allenleejy/digicam/design/phone-v2/mockup.html

9:41

# sam's camera

24 photos2 videos80%

## New

6 not saved

## Saved

20

Select Save 6 new

LibraryThe camera's name in its own pixel font. New photos come first, so the main button always does the obvious thing. One floating bar, like Photos.

9:41

03/24 142 KB

Press and hold the photo to save it

Save

ViewerAlways dark, so the photo is the brightest thing on screen. Swipe sideways between photos, swipe down to close. The hint shows the first few times only.

9:41

Cancel

# 4 selected

All new

Save 4 to Photos

Select (dark mode)Drag across tiles to pick several at once. Picked tiles get an orange ring as well as the tick, so they're easy to spot at a glance.

9:41

# hi, sam

Your camera isn't connected. Two steps and your photos show up here.

1

Turn on Phone modeOn the camera, hold the middle button and pick the phone.

2

Join the camera's Wi-FiSettings, then Wi-Fi. It's saved, so no password this time.
digicam-sam

Looking for the camera

Not connectedWhat the home-screen app shows when opened away from the camera, if iOS keeps a copy of the page (to test). It keeps checking and opens the library by itself once the camera appears.

9:41

# sam's camera

24 photos2 videos

192.168.4.1

## Keep Digicam on your Home Screen

Opens full screen, like an app. Free, once.

- Tap Share in Safari's toolbar
- Choose Add to Home Screen
- Open Digicam from there next time

Not nowShow me

First visit, in SafariA one-time card asking to add the page to the Home Screen. It never shows inside the home-screen app itself.
