allenleejy/digicam/cad/renders/back.png

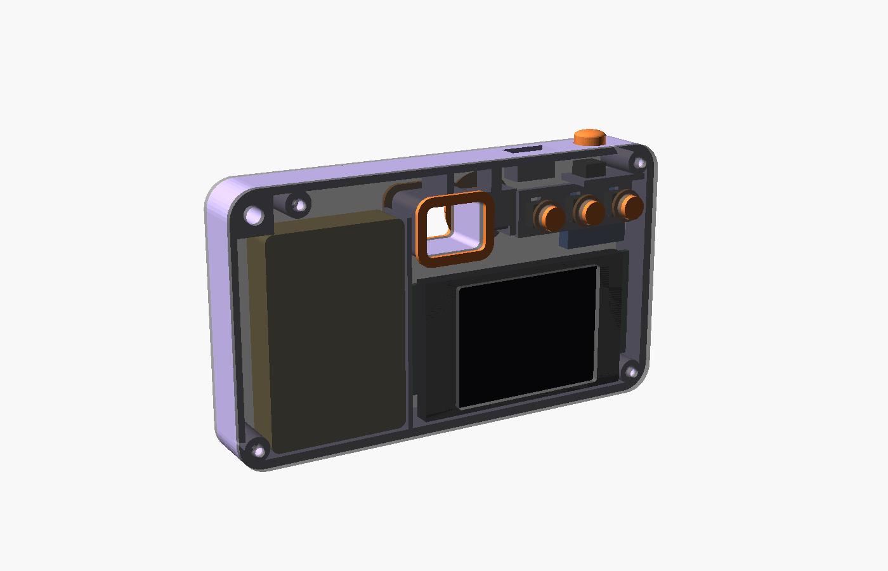
cad/renders/back.png
