allenleejy/digicam/cad/renders/exploded.png

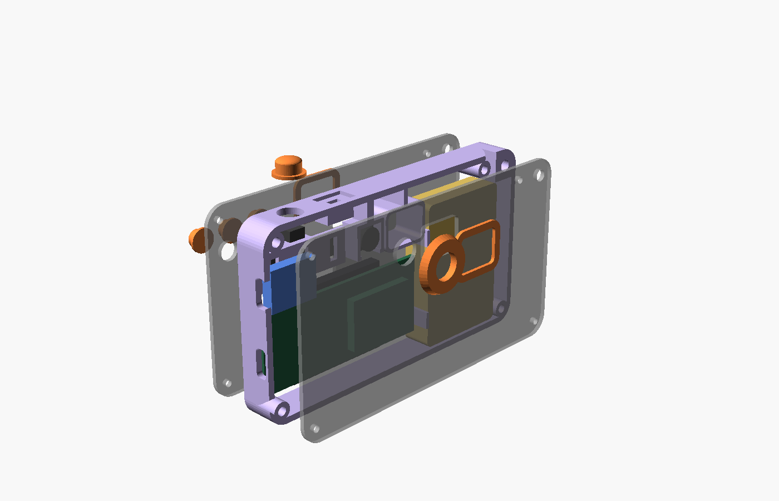
cad/renders/exploded.png
