allenleejy/digicam/cad/renders/front.png

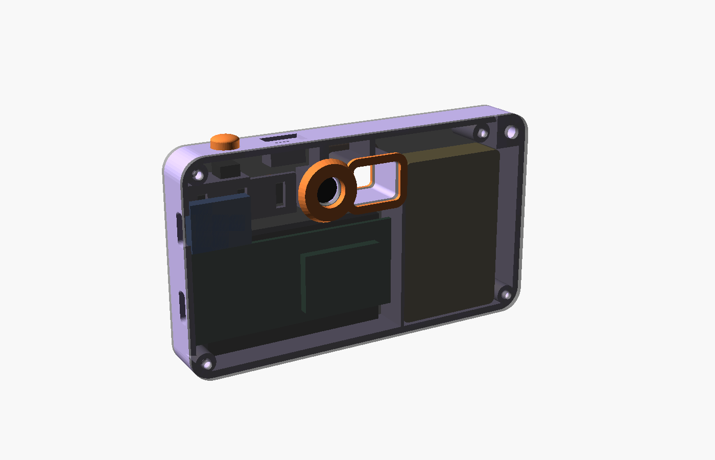
cad/renders/front.png
