allenleejy/digicam/cad/renders/fusion_back.png

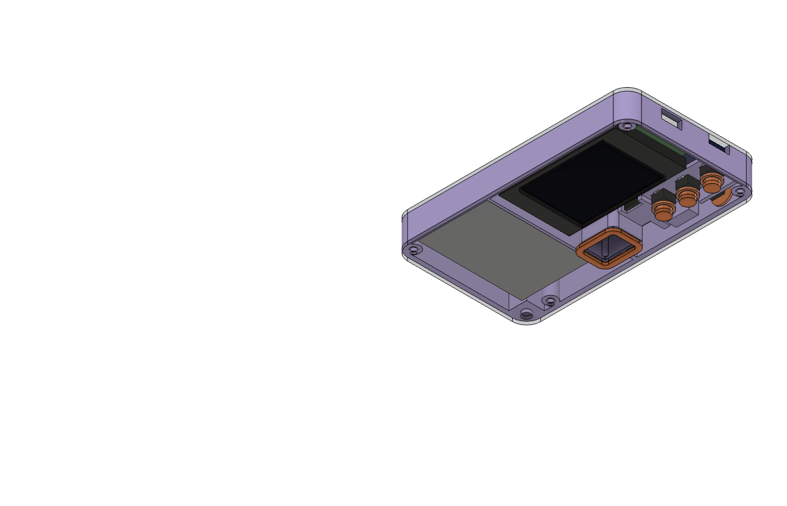
cad/renders/fusion_back.png
