allenleejy/digicam/cad/renders/fusion_front.png

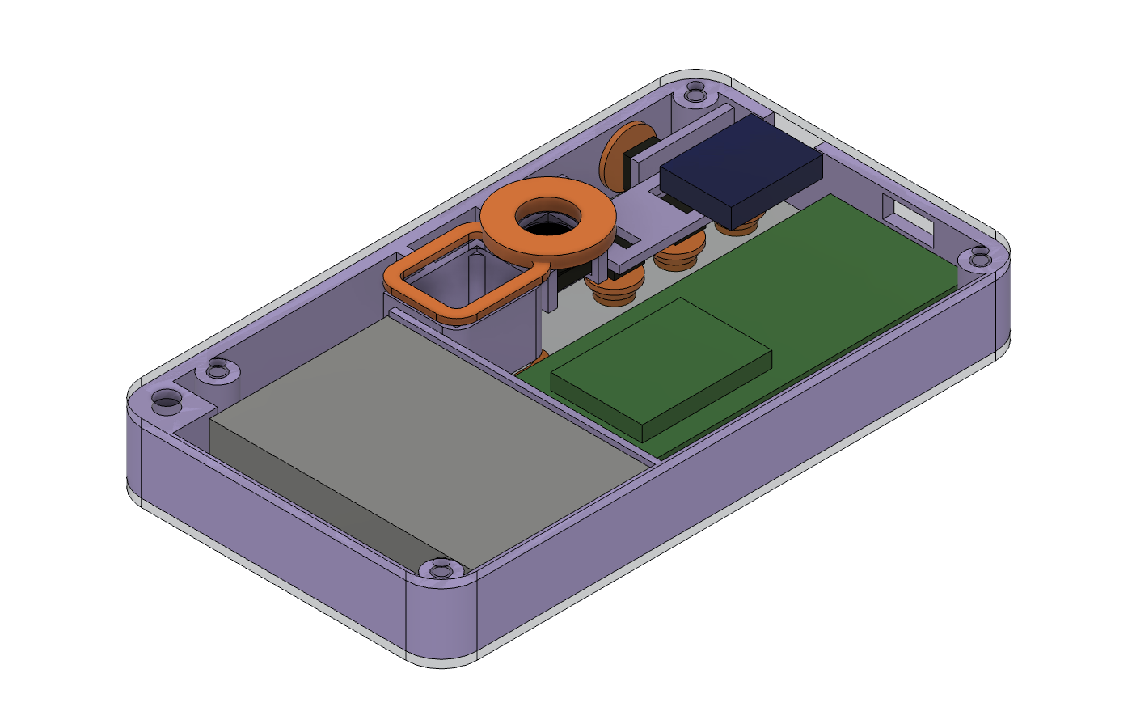
cad/renders/fusion_front.png
