allenleejy/digicam/cad/renders/screen-compare.png

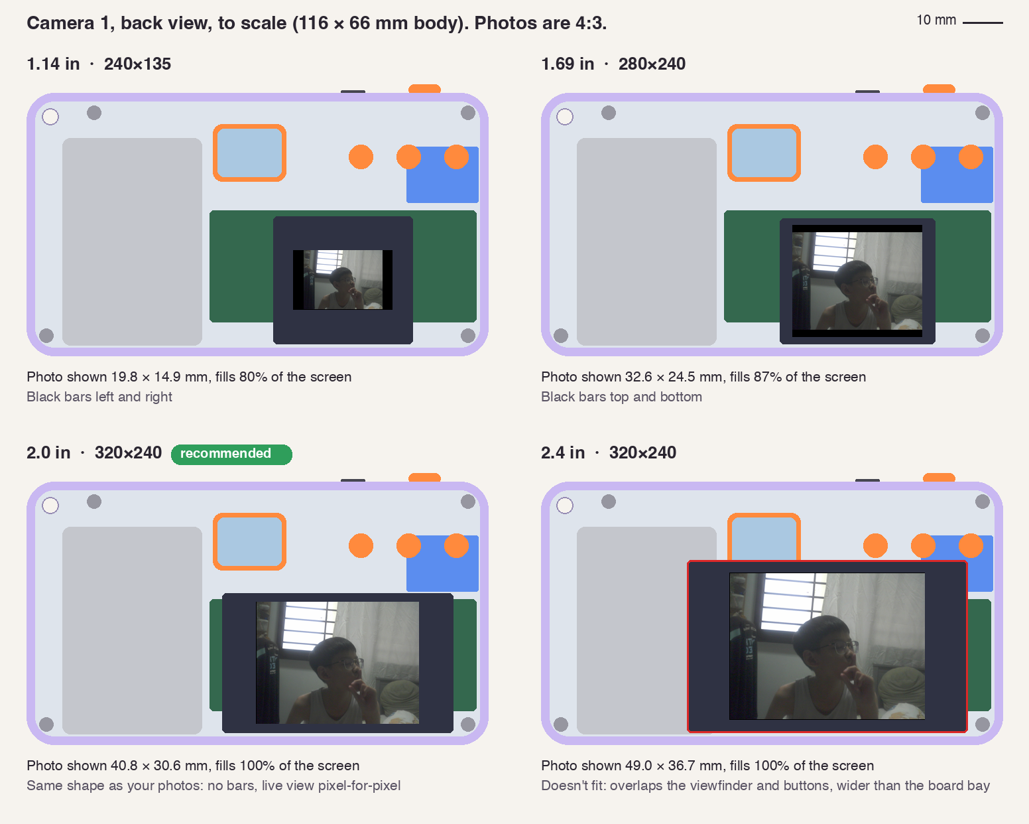
cad/renders/screen-compare.png
