allenleejy/digicam/cad/renders/simulator-2in.jpg

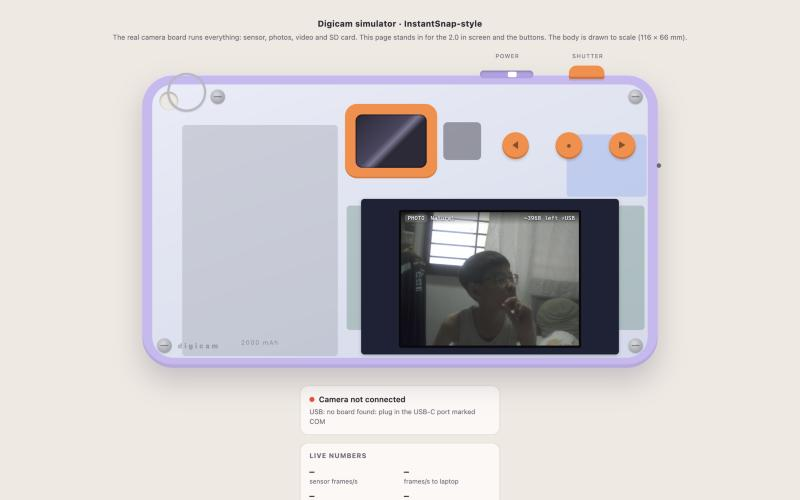
cad/renders/simulator-2in.jpg
