allenleejy/digicam/cad/renders/top.png

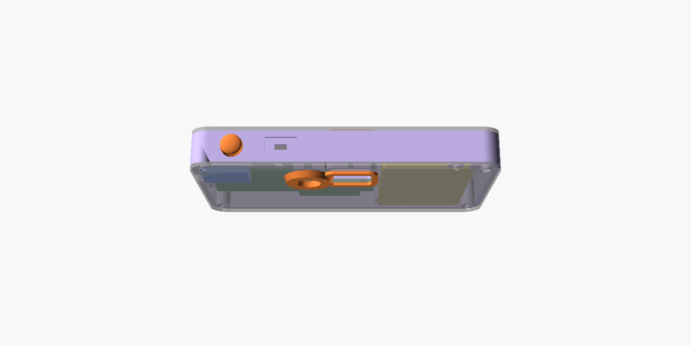
cad/renders/top.png
