allenleejy/digicam/cad/renders/v3/clear_exploded.png

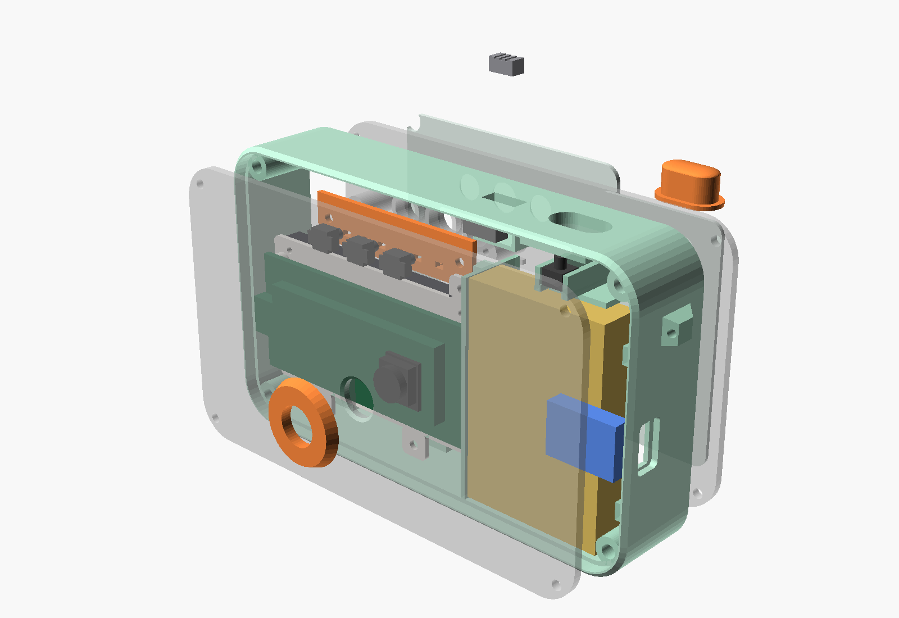
cad/renders/v3/clear_exploded.png
