allenleejy/digicam/cad/renders/v3/clear_front.png

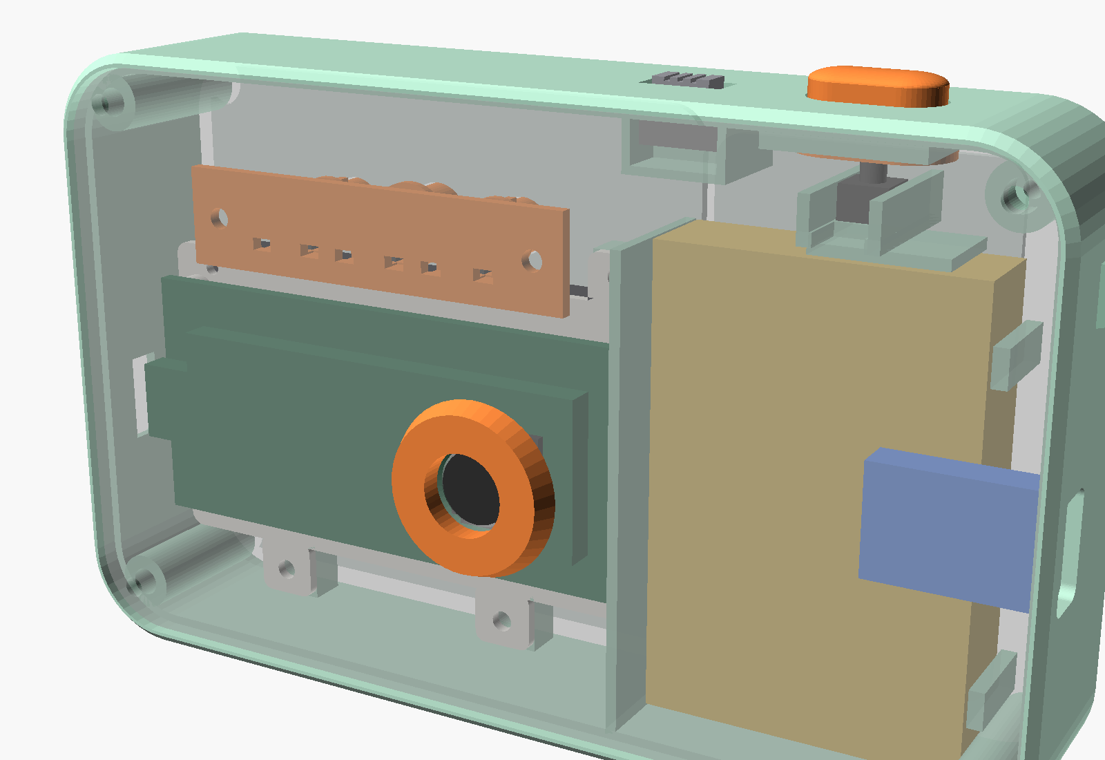
cad/renders/v3/clear_front.png
