allenleejy/digicam/cad/renders/v3/clear_inside.png

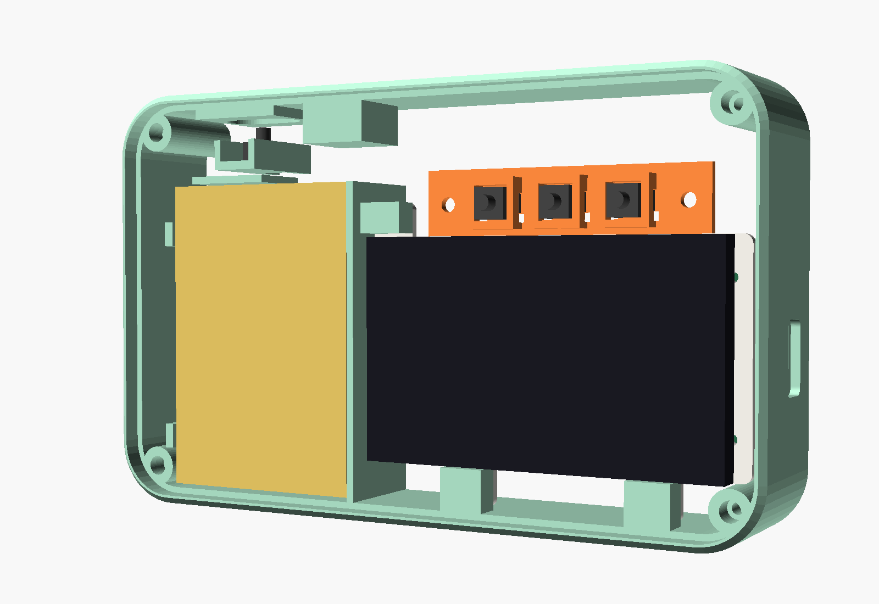
cad/renders/v3/clear_inside.png
