allenleejy/digicam/cad/renders/v3/retro_back.png

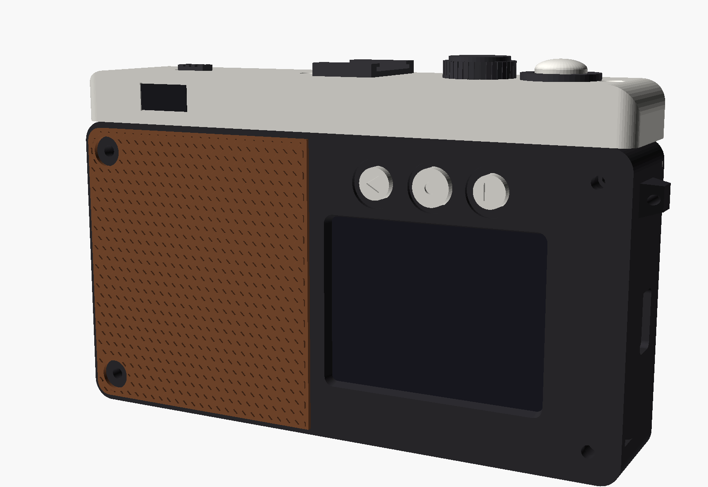
cad/renders/v3/retro_back.png
