allenleejy/digicam/cad/renders/v3/retro_exploded.png

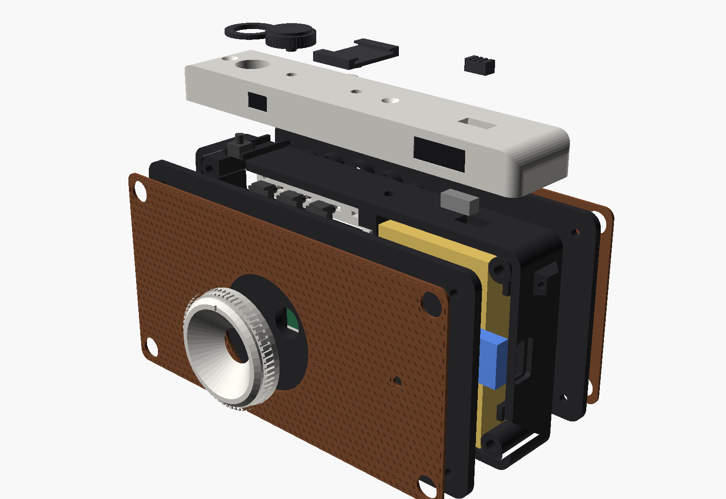
cad/renders/v3/retro_exploded.png
