allenleejy/digicam/cad/renders/v3/retro_inside.png

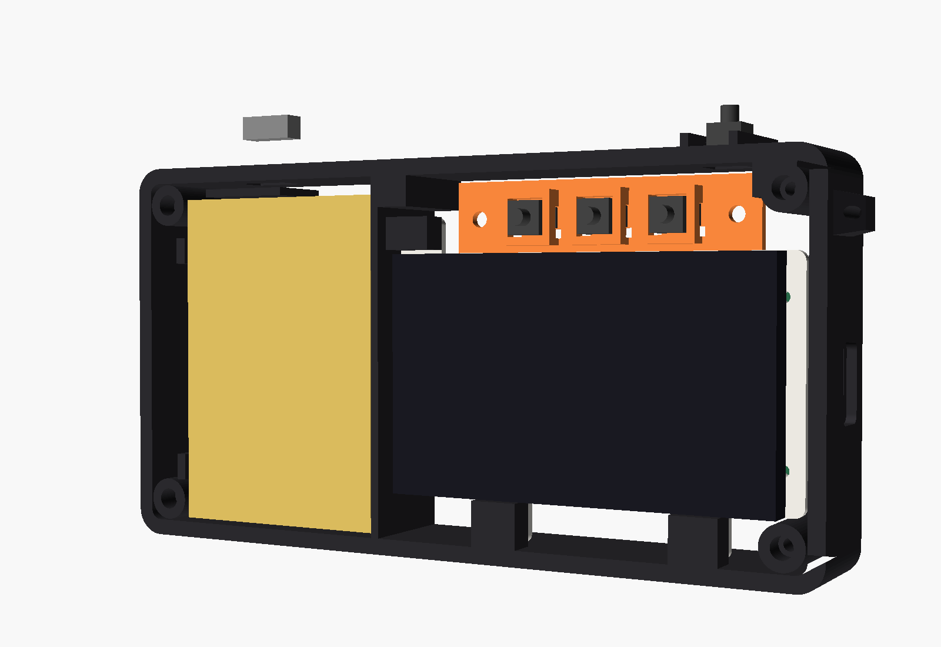
cad/renders/v3/retro_inside.png
