allenleejy/digicam/cad/renders/v3/sheet.png

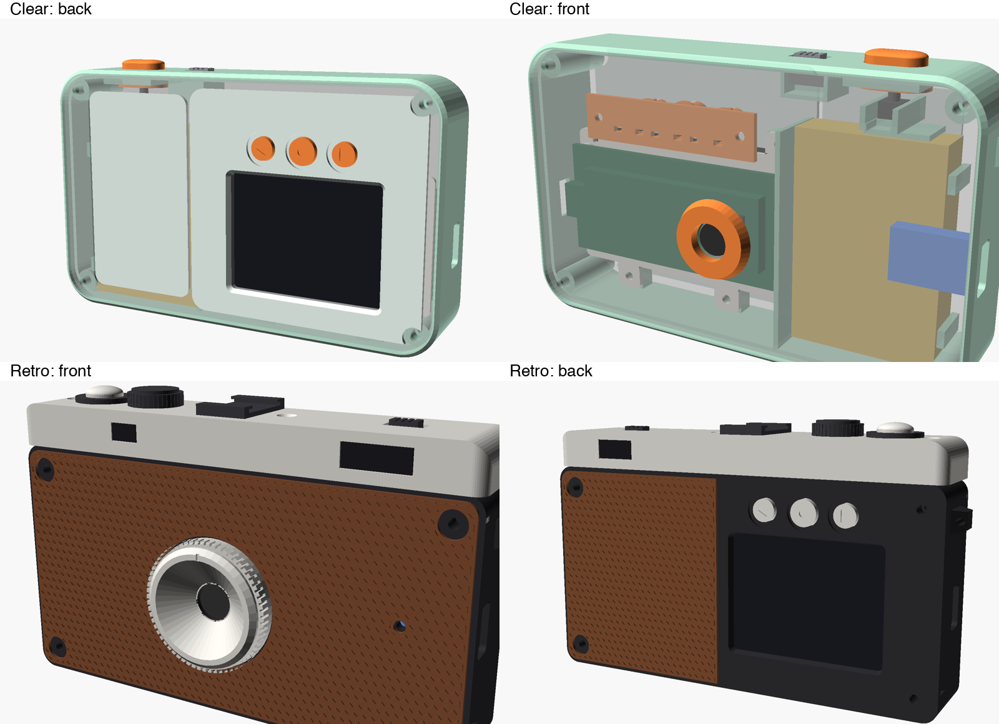
cad/renders/v3/sheet.png
