allenleejy/digicam/design/phone-v2/img/full.jpg

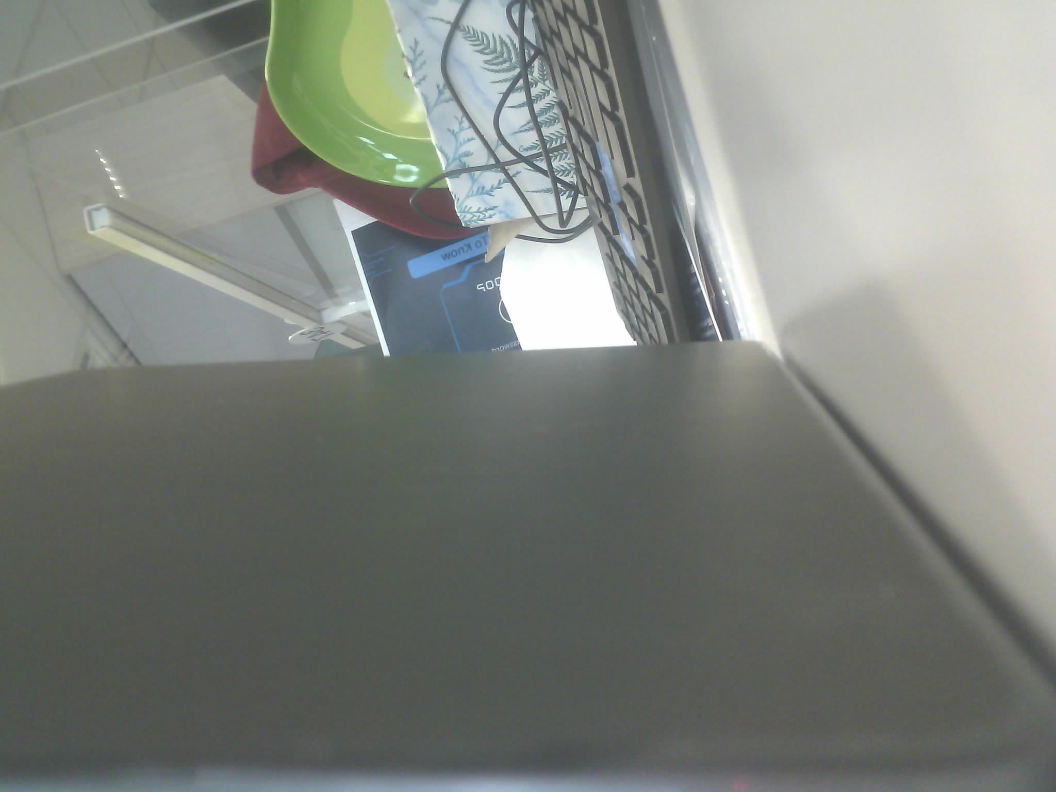
design/phone-v2/img/full.jpg
