allenleejy/digicam/design/phone-v2/img/t_DSC_0005.JPG

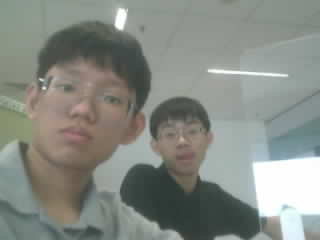
design/phone-v2/img/t_DSC_0005.JPG
