allenleejy/digicam/design/phone-v2/img/t_DSC_0006.JPG

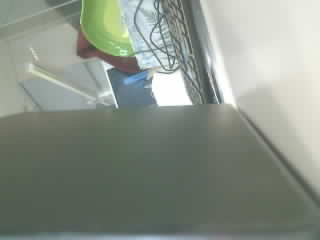
design/phone-v2/img/t_DSC_0006.JPG
