allenleejy/digicam/firmware/sim/out/01-boot.png

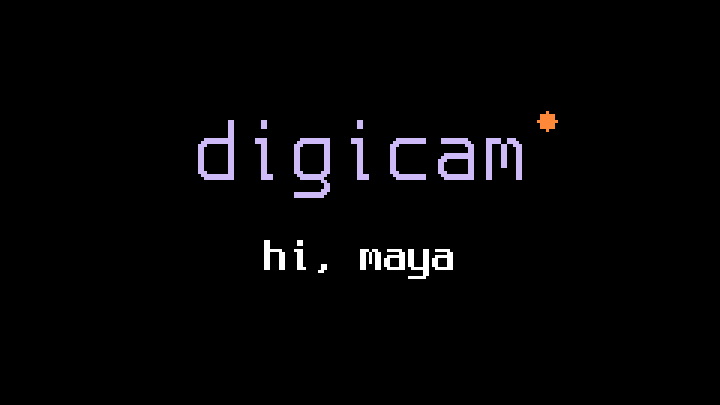
firmware/sim/out/01-boot.png
