allenleejy/digicam/firmware/sim/out/02-live-photo.png

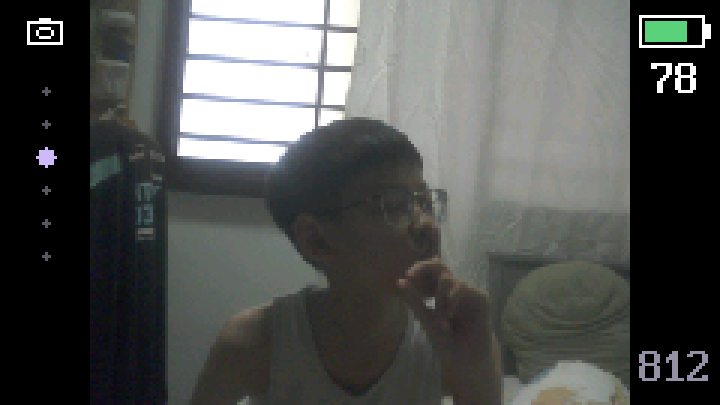
firmware/sim/out/02-live-photo.png
