allenleejy/digicam/firmware/sim/out/06-shutter-flash.png

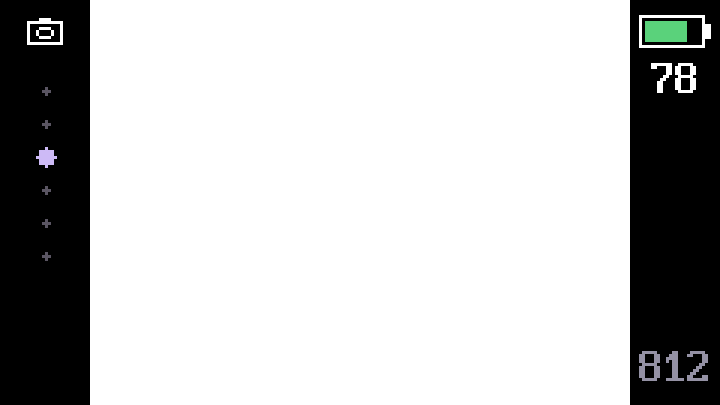
firmware/sim/out/06-shutter-flash.png
