allenleejy/digicam/firmware/sim/out/11-mode-dial.png

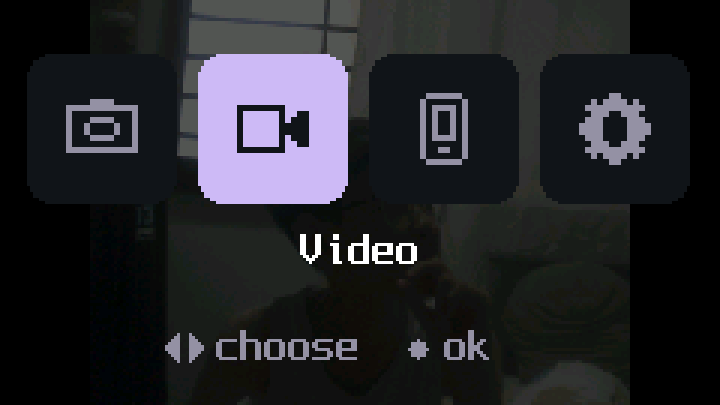
firmware/sim/out/11-mode-dial.png
