allenleejy/digicam/firmware/sim/out/14-delete.png

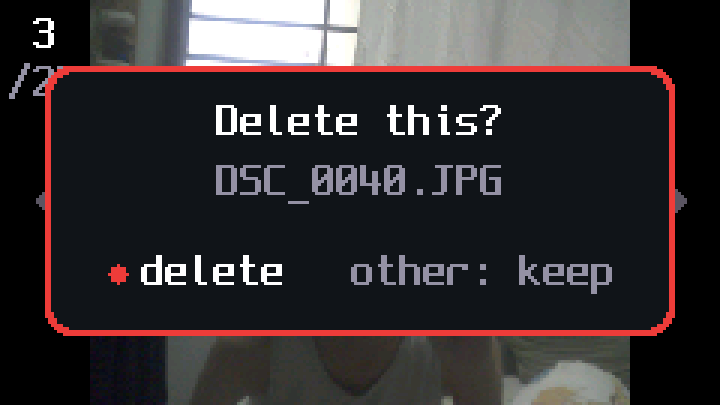
firmware/sim/out/14-delete.png
