allenleejy/digicam/firmware/sim/out/15-gallery-empty.png

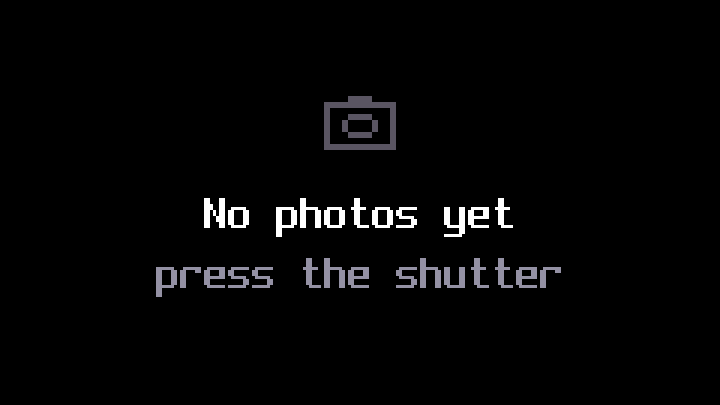
firmware/sim/out/15-gallery-empty.png
