allenleejy/digicam/firmware/sim/out/16-settings.png

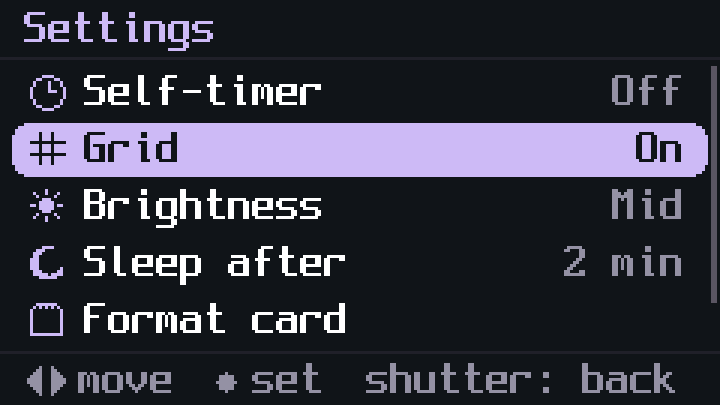
firmware/sim/out/16-settings.png
