allenleejy/digicam/firmware/sim/out/17-format.png

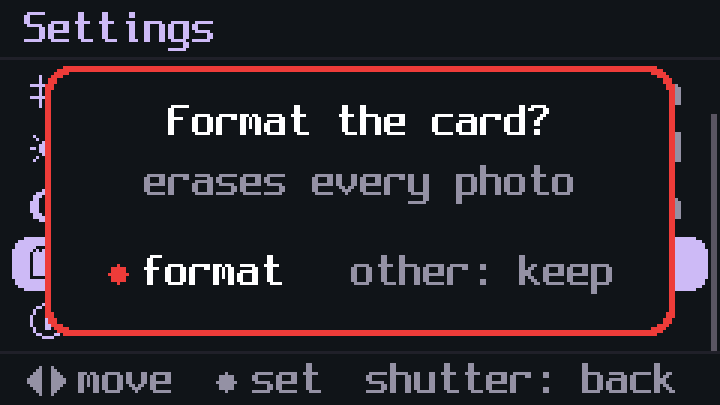
firmware/sim/out/17-format.png
