allenleejy/digicam/firmware/sim/out/18-about.png

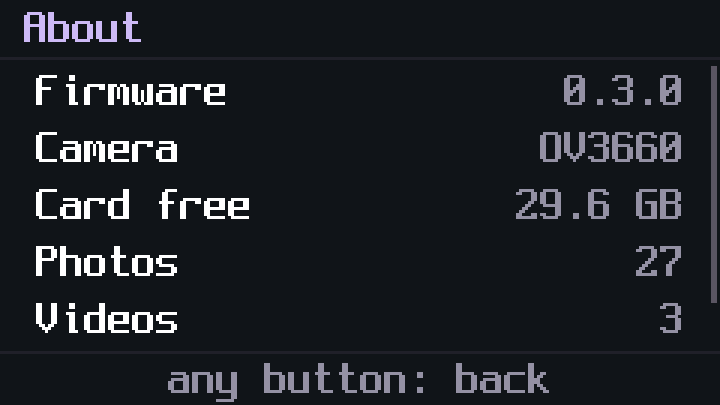
firmware/sim/out/18-about.png
