allenleejy/digicam/firmware/sim/out/19-no-camera.png

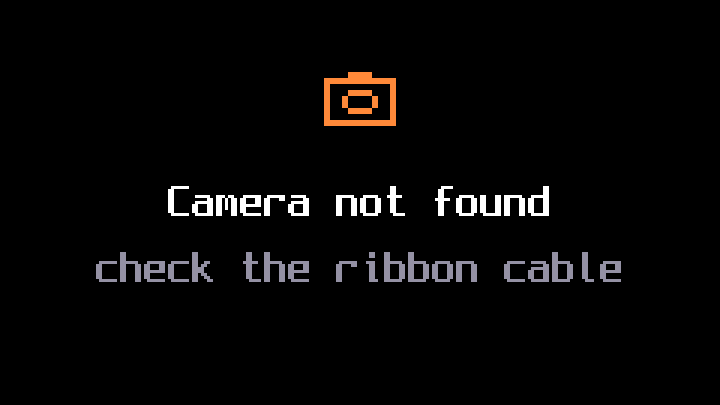
firmware/sim/out/19-no-camera.png
