allenleejy/digicam/firmware/sim/out/21-mode-phone.png

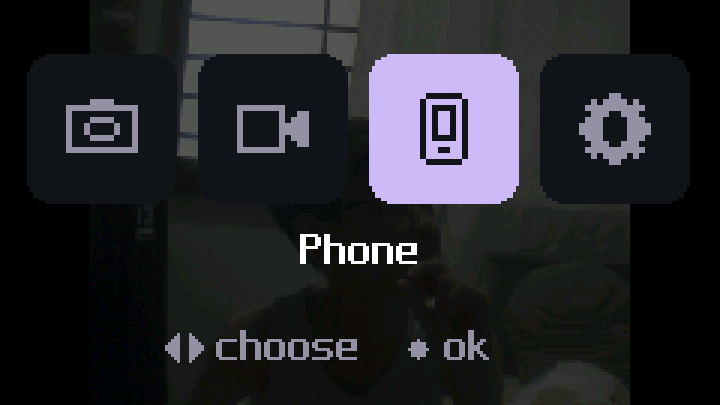
firmware/sim/out/21-mode-phone.png
