allenleejy/digicam/firmware/sim/out/22-phone-join.png

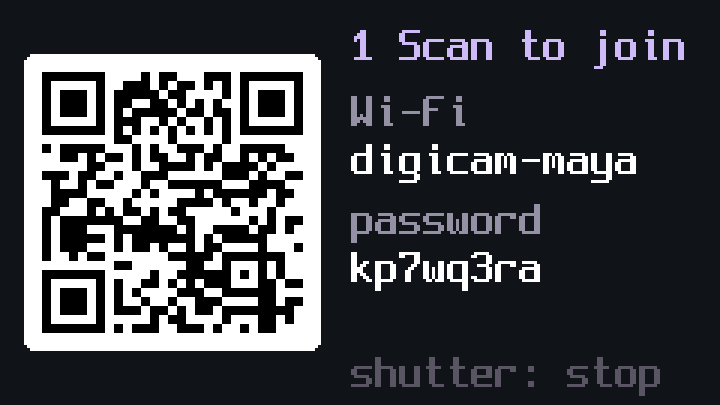
firmware/sim/out/22-phone-join.png
