allenleejy/digicam/firmware/sim/out/23-phone-open.png

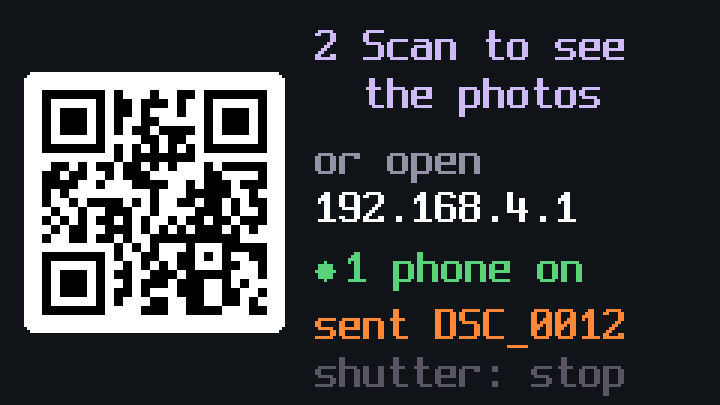
firmware/sim/out/23-phone-open.png
