allenleejy/digicam/firmware/sim/out/phone-screens.png

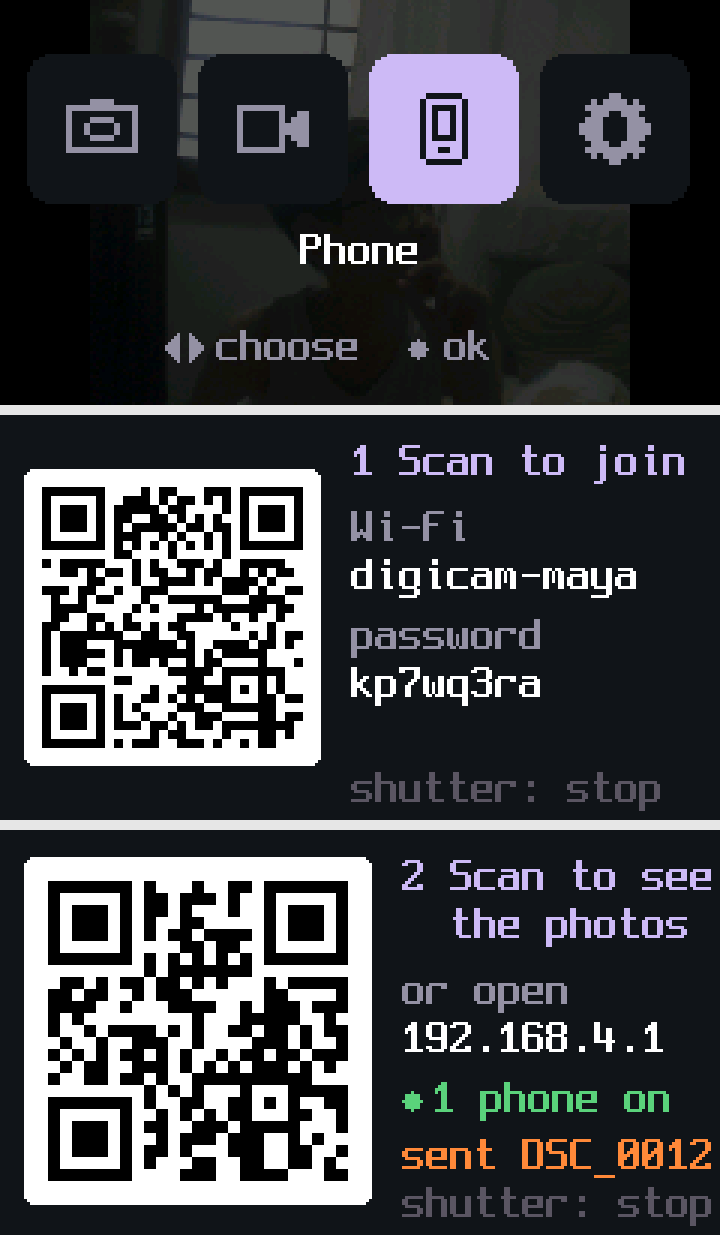
firmware/sim/out/phone-screens.png
