allenleejy/digicam/firmware/sim/out/sheet.png

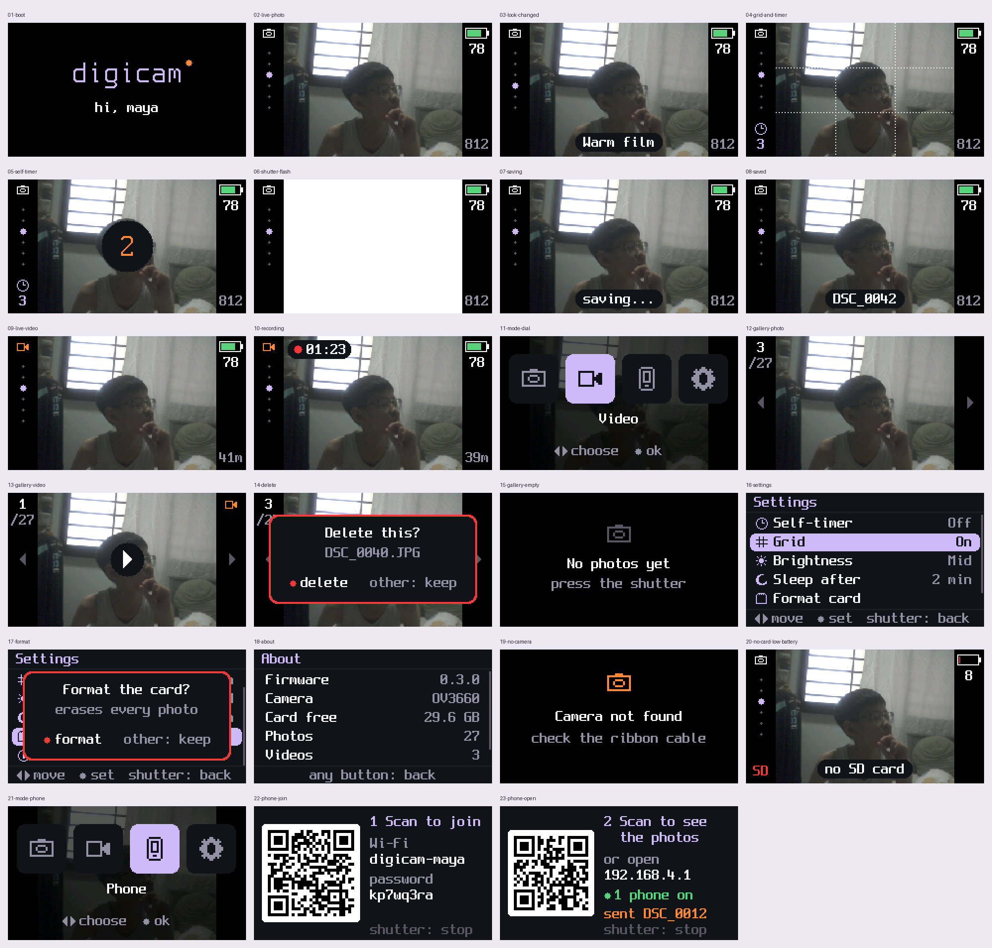
firmware/sim/out/sheet.png
