allenleejy/digicam/host/shots/a-mode.png

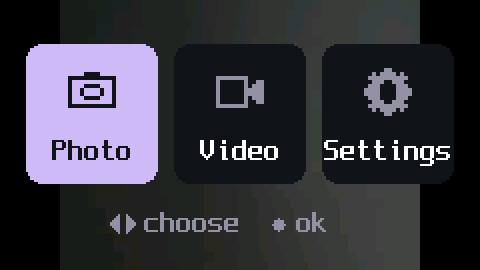
host/shots/a-mode.png
