allenleejy/digicam/host/shots/b-mode-settings.png

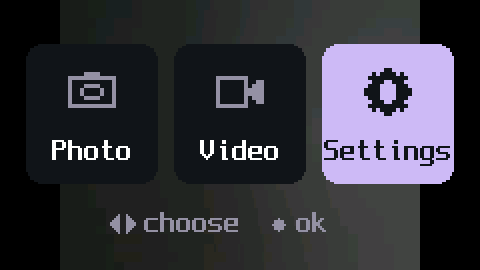
host/shots/b-mode-settings.png
