allenleejy/digicam/host/shots/c-settings.png

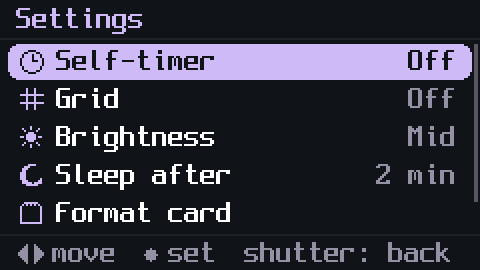
host/shots/c-settings.png
