allenleejy/digicam/host/shots/f-live-grid.png

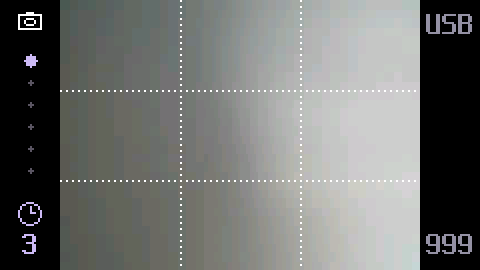
host/shots/f-live-grid.png
