allenleejy/digicam/host/shots/g-countdown.png

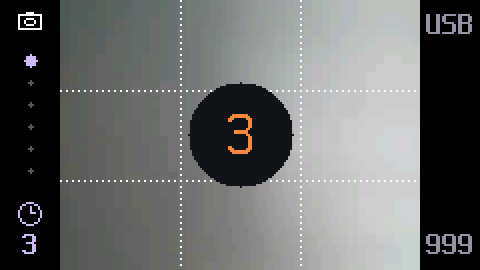
host/shots/g-countdown.png
