allenleejy/digicam/host/shots/p1-dial.png

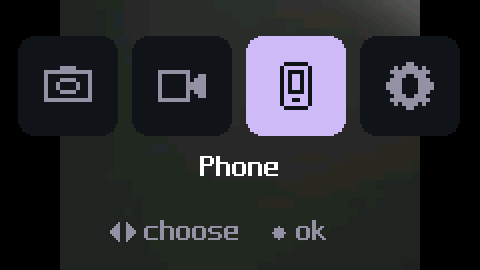
host/shots/p1-dial.png
