allenleejy/digicam/host/shots/p2-phone.png

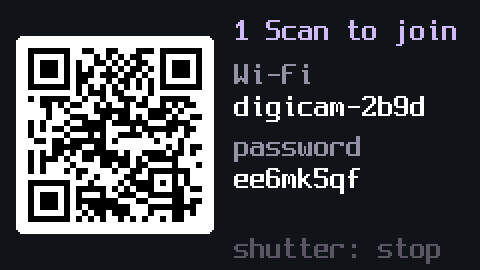
host/shots/p2-phone.png
