allenleejy/digicam/host/shots/walk.png

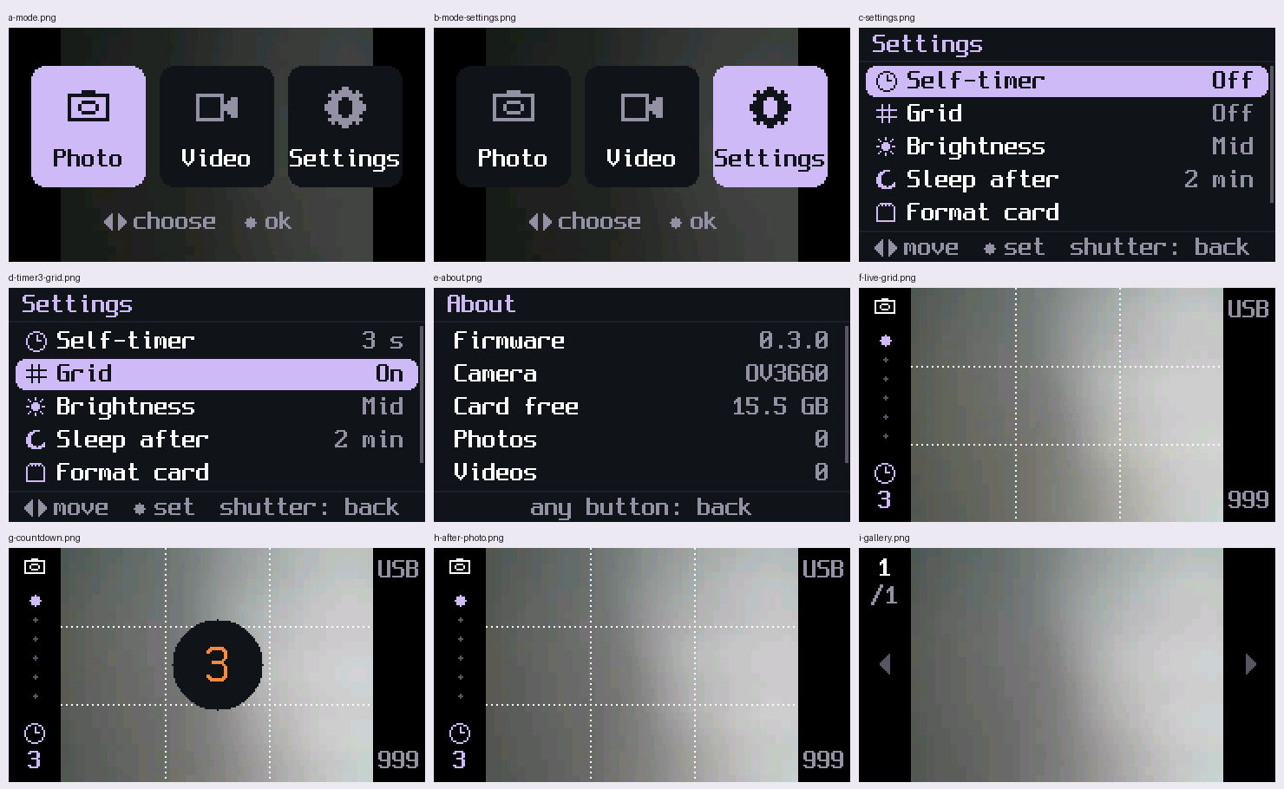
host/shots/walk.png
