allenleejy/digicam/cad/export/camera1_assembly.step

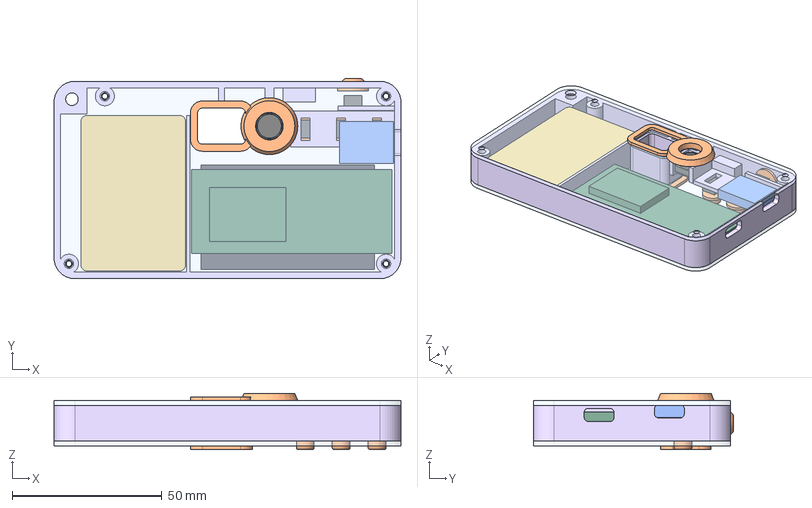
[picture p48: CAD file, 2026-10-21]
cad/export/camera1_assembly.step
116.0 x 67.0 x 18.8 mm
Frame
Back plate (clear)
Front plate (clear)
Lens ring
Viewfinder trim front
Viewfinder trim back
Shutter cap
Button cap prev
Button cap ok
Button cap next
REF battery 103450 2000mAh
REF GOOUUU ESP32-S3-CAM board
REF screen 2.0 in module
REF charge-boost module
REF OV3660 camera module
REF back buttons x3
REF shutter switch
REF slide switch
