allenleejy/digicam/cad/export/step_parts/button_cap_ok.step

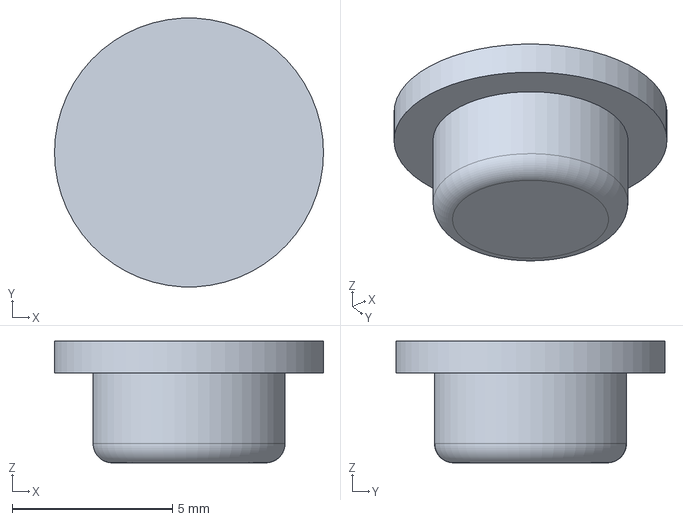
[picture p49: CAD file, 2026-10-21]
cad/export/step_parts/button_cap_ok.step
8.40 x 8.39 x 3.80 mm
