allenleejy/digicam/cad/export/v3/clear/back_plate.stl

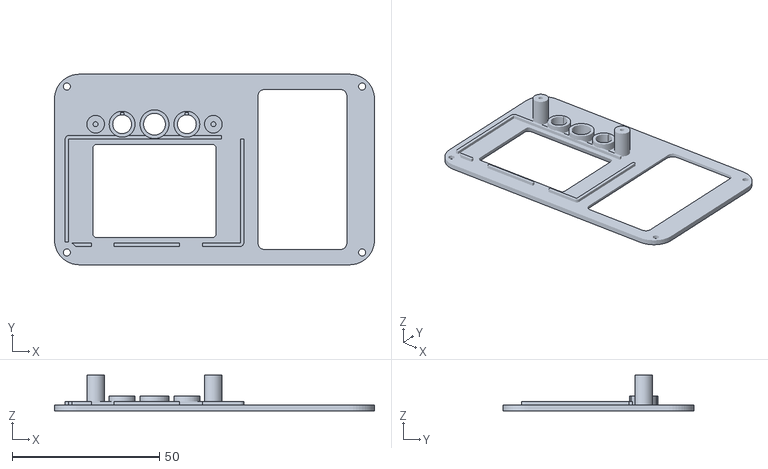
[picture p50: CAD file, 2026-10-23]
cad/export/v3/clear/back_plate.stl
108.8 x 64.8 x 12.1
