allenleejy/digicam/cad/export/v3/retro/window_inserts.stl

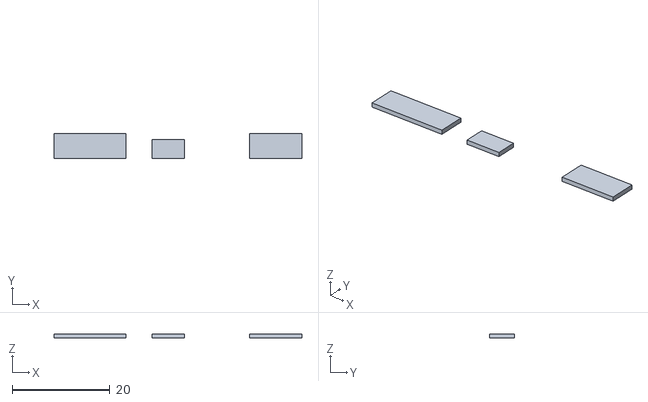
[picture p51: CAD file, 2026-10-23]
cad/export/v3/retro/window_inserts.stl
50.7 x 5.10 x 0.8
