allenleejy/digicam/guide/models/w_screen_4.stl

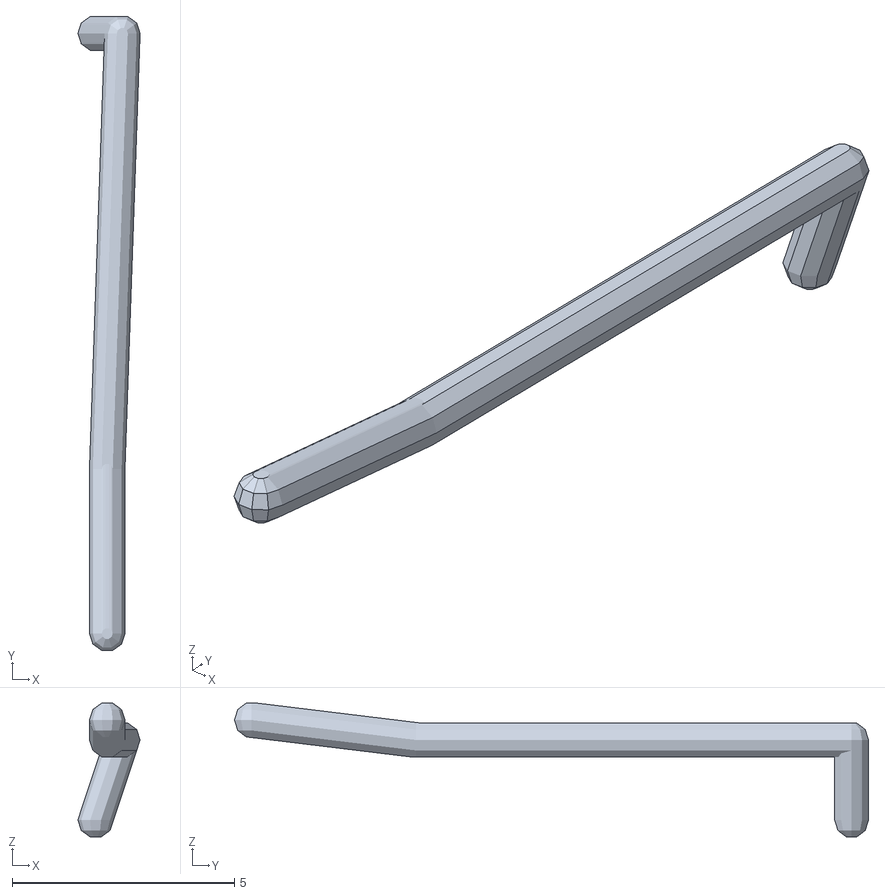
[picture p52: CAD file, 2026-10-21]
guide/models/w_screen_4.stl
1.40 x 14.3 x 3.01
