allenleejy/digicam/cad/export/step_parts/front_plate.step

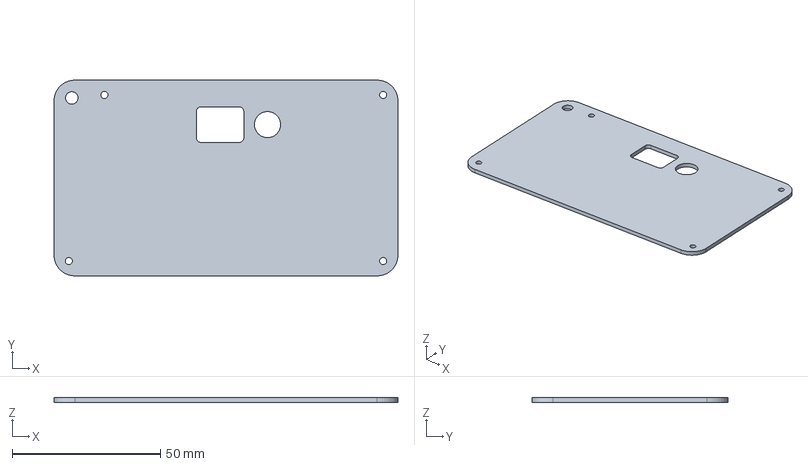
[picture p53: CAD file, 2026-10-21]
cad/export/step_parts/front_plate.step
116.0 x 66.0 x 1.60 mm
