allenleejy/digicam/cad/export/v3/clear/carrier.stl

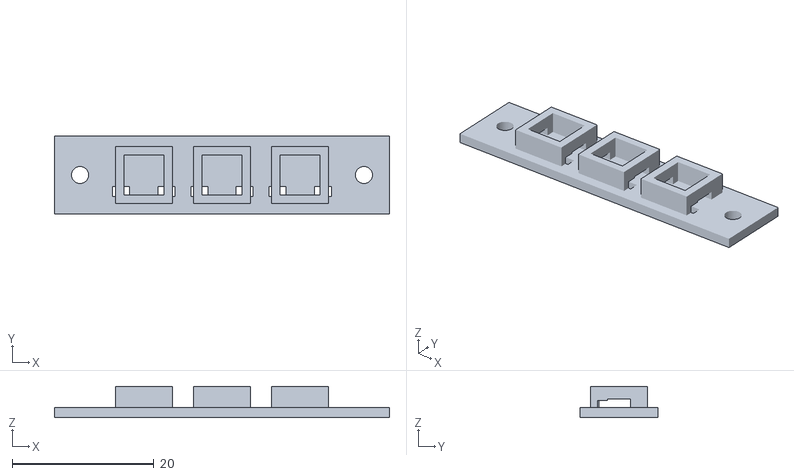
[picture p54: CAD file, 2026-10-23]
cad/export/v3/clear/carrier.stl
47.2 x 11.0 x 4.40
