allenleejy/digicam/cad/export/v3/retro/sled.stl

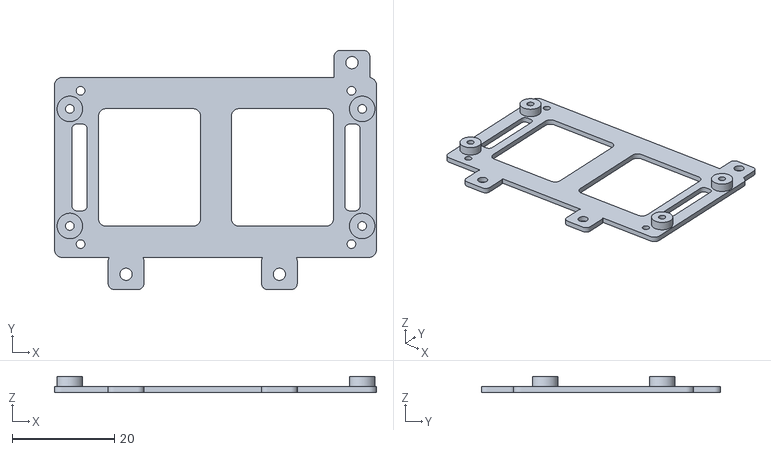
[picture p55: CAD file, 2026-10-23]
cad/export/v3/retro/sled.stl
63.0 x 46.8 x 3.20
