allenleejy/digicam/guide/models/frame.stl

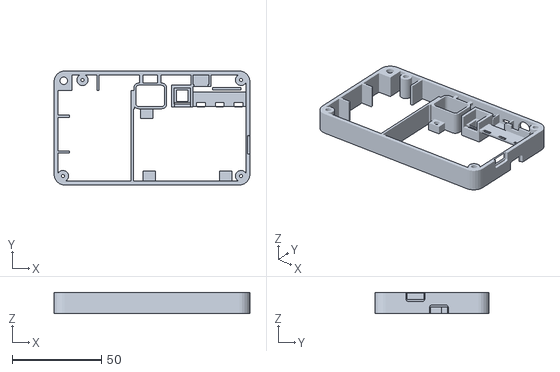
[picture p56: CAD file, 2026-10-21]
guide/models/frame.stl
110.0 x 64.0 x 11.9
