allenleejy/digicam/cad/export/step_parts/shutter_cap.step

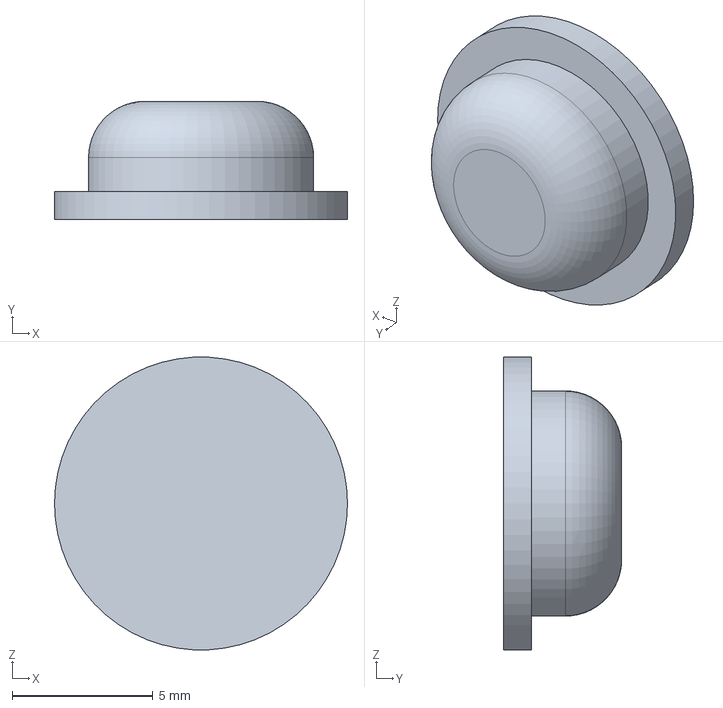
[picture p57: CAD file, 2026-10-21]
cad/export/step_parts/shutter_cap.step
10.4 x 4.20 x 10.4 mm
