allenleejy/digicam/cad/export/v3/clear/front_plate.stl

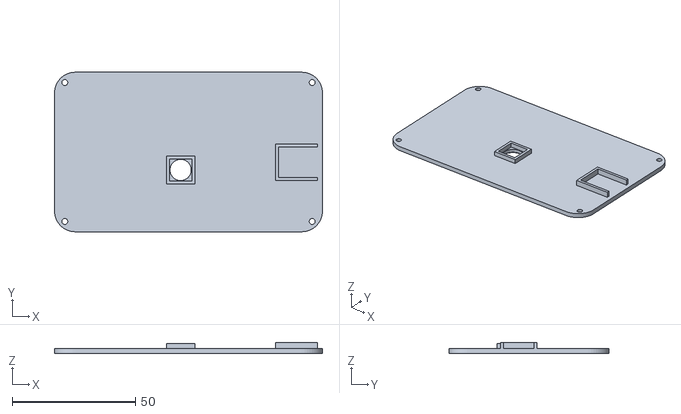
[picture p58: CAD file, 2026-10-23]
cad/export/v3/clear/front_plate.stl
108.8 x 64.8 x 4.50
