allenleejy/digicam/cad/export/v3/retro/lens_barrel.stl

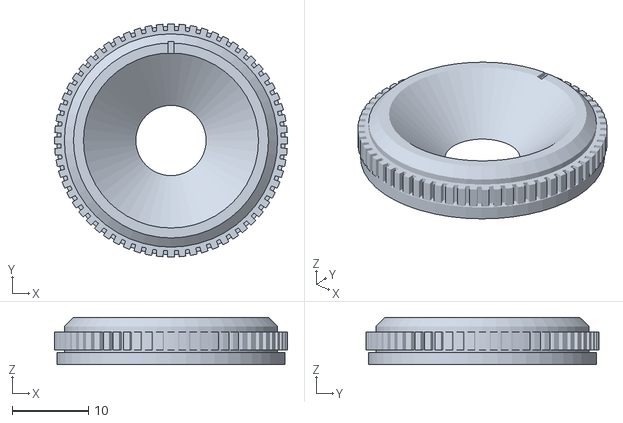
[picture p59: CAD file, 2026-10-23]
cad/export/v3/retro/lens_barrel.stl
30.6 x 30.6 x 6.20
