allenleejy/digicam/guide/models/w_gnd.stl

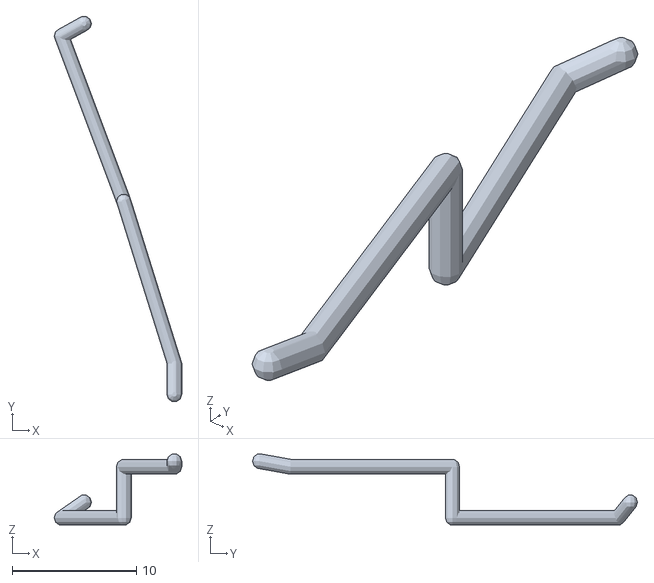
[picture p60: CAD file, 2026-10-21]
guide/models/w_gnd.stl
10.3 x 30.9 x 5.69
