allenleejy/digicam/cad/export/step_parts/lens_ring.step

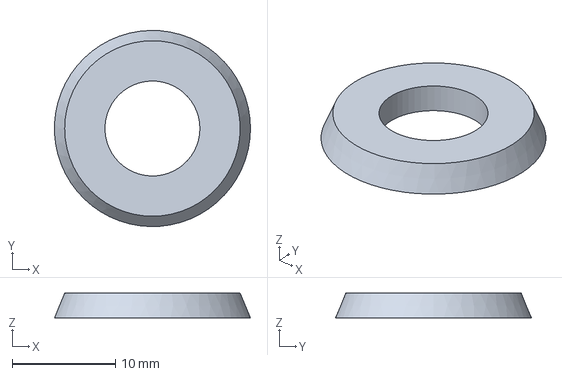
[picture p61: CAD file, 2026-10-21]
cad/export/step_parts/lens_ring.step
19.0 x 19.0 x 2.40 mm
