allenleejy/digicam/cad/export/v3/retro/frame.stl

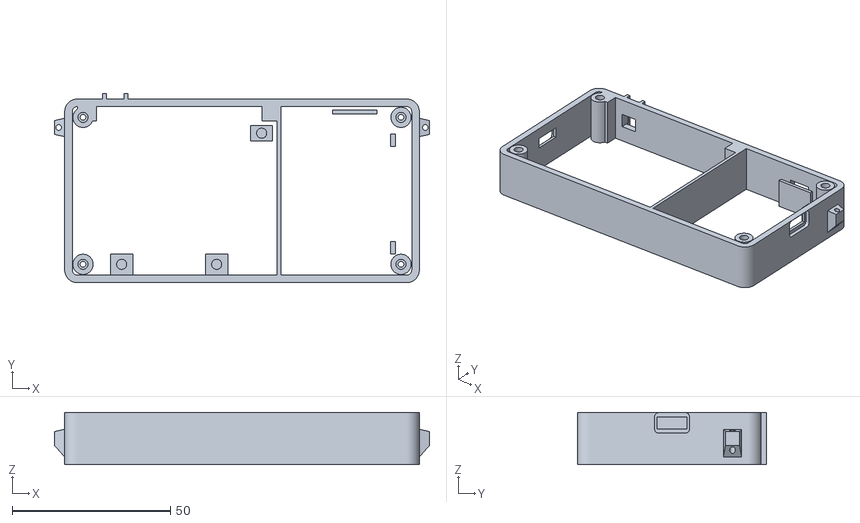
[picture p62: CAD file, 2026-10-23]
cad/export/v3/retro/frame.stl
118.4 x 59.8 x 16.5
