allenleejy/digicam/cad/export/vf_frames.stl

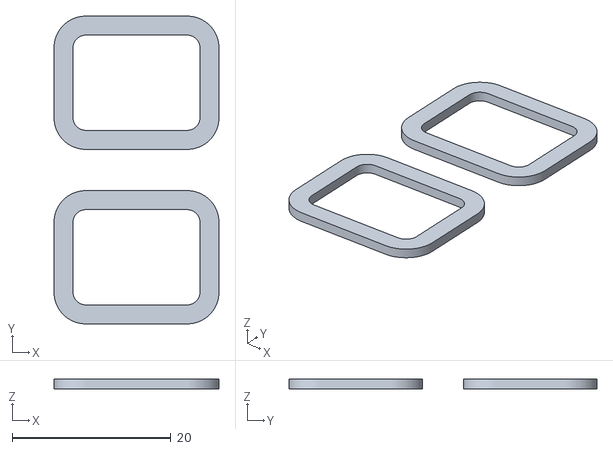
[picture p63: CAD file, 2026-10-21]
cad/export/vf_frames.stl
20.8 x 38.8 x 1.20
