allenleejy/digicam/cad/export/step_parts/frame.step

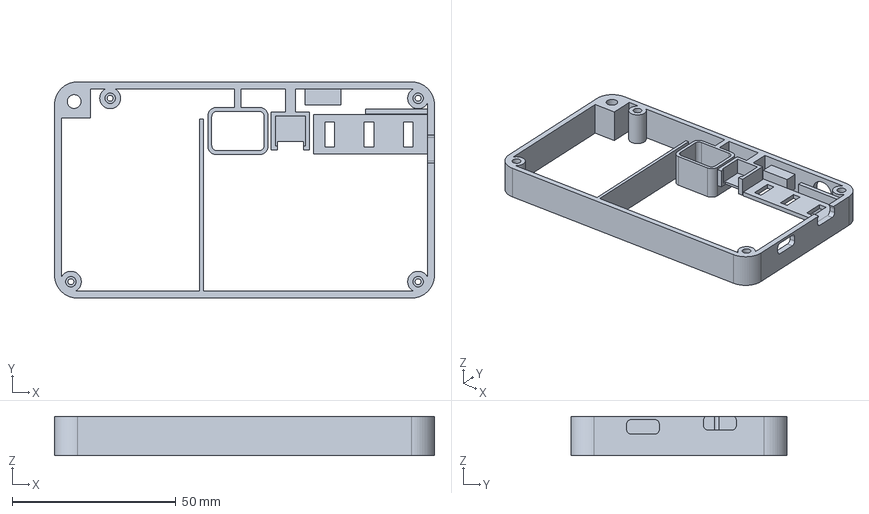
[picture p64: CAD file, 2026-10-21]
cad/export/step_parts/frame.step
116.0 x 66.0 x 12.0 mm
