allenleejy/digicam/cad/export/v3/retro/top_plate.stl

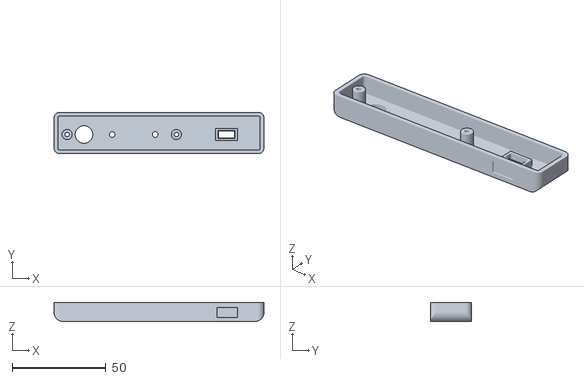
[picture p65: CAD file, 2026-10-23]
cad/export/v3/retro/top_plate.stl
112.0 x 22.1 x 10.2
