allenleejy/digicam/guide/models/vf_front.stl

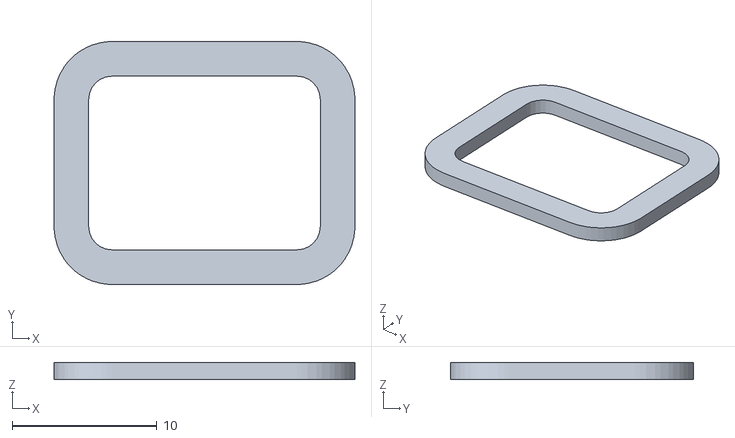
[picture p66: CAD file, 2026-10-21]
guide/models/vf_front.stl
20.8 x 16.8 x 1.20
