allenleejy/digicam/cad/export/v3/clear/bezel.stl

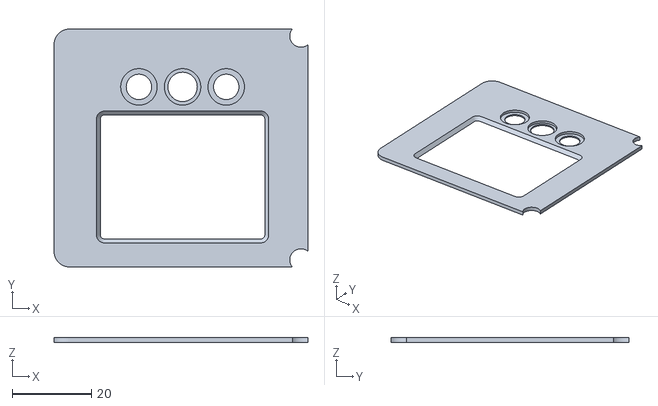
[picture p67: CAD file, 2026-10-23]
cad/export/v3/clear/bezel.stl
64.0 x 60.0 x 1.20
