allenleejy/digicam/cad/export/v3/retro/leatherette.stl

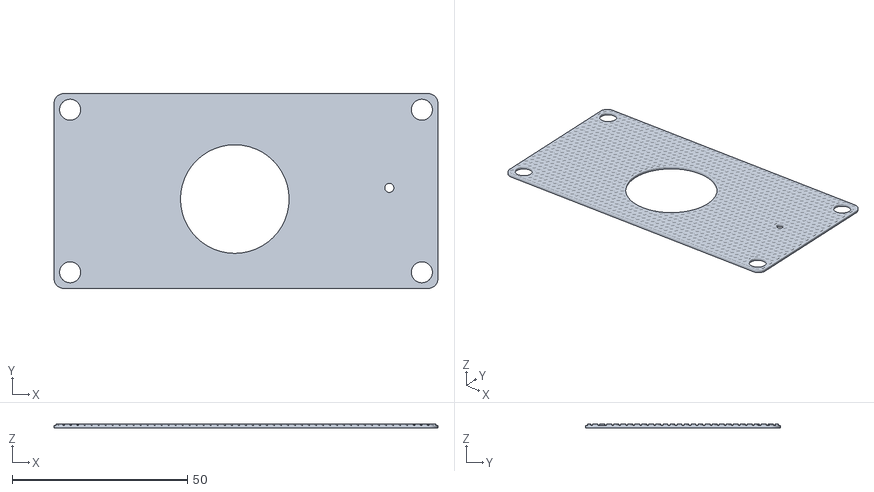
[picture p68: CAD file, 2026-10-23]
cad/export/v3/retro/leatherette.stl
109.6 x 55.6 x 1.19
