allenleejy/digicam/guide/models/board_pads.stl

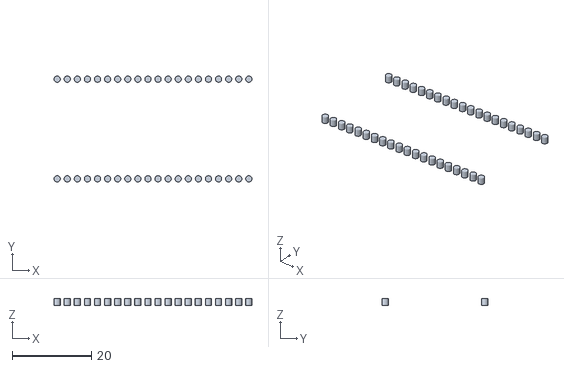
[picture p69: CAD file, 2026-10-21]
guide/models/board_pads.stl
49.9 x 26.7 x 1.70
