allenleejy/digicam/cad/export/v3/clear/frame.stl

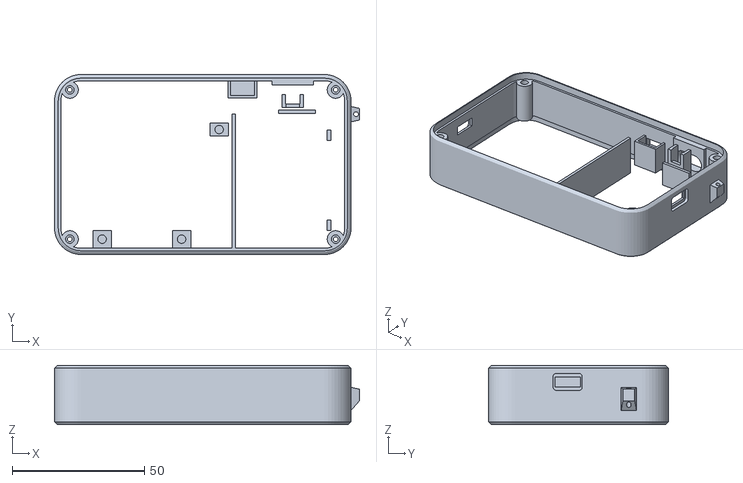
[picture p70: CAD file, 2026-10-23]
cad/export/v3/clear/frame.stl
115.2 x 68.0 x 22.3
