allenleejy/digicam/cad/export/v3/retro/front_plate.stl

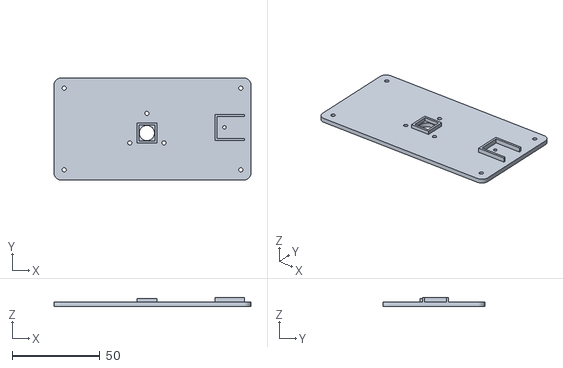
[picture p71: CAD file, 2026-10-23]
cad/export/v3/retro/front_plate.stl
112.0 x 58.0 x 4.90
