allenleejy/digicam/guide/models/w_screen_2.stl

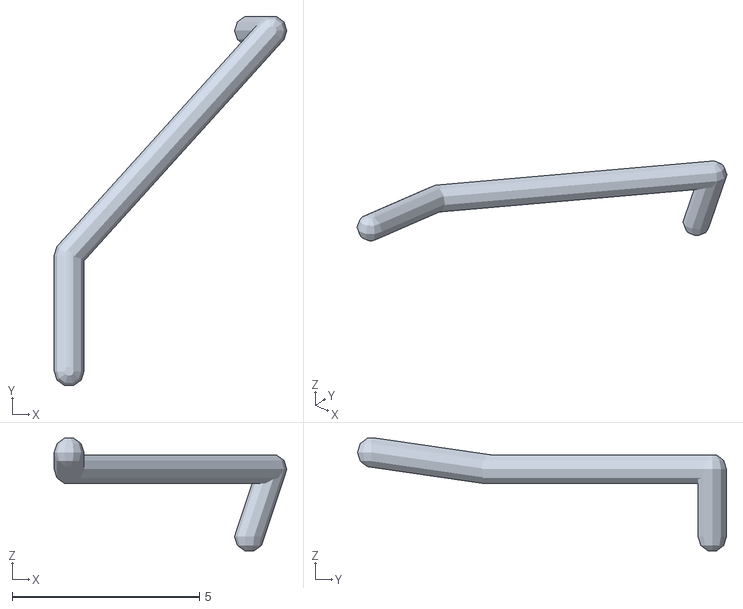
[picture p72: CAD file, 2026-10-21]
guide/models/w_screen_2.stl
6.22 x 9.86 x 3.01
