allenleejy/digicam/cad/export/v3/clear/caps.stl

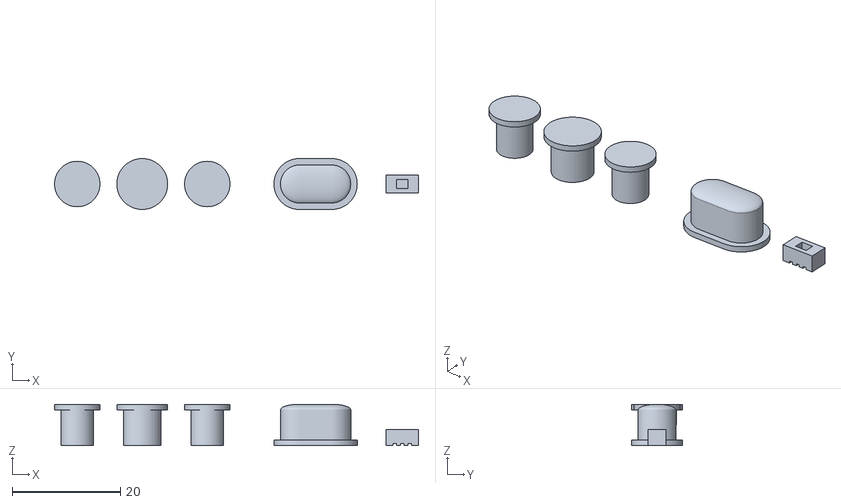
[picture p74: CAD file, 2026-10-23]
cad/export/v3/clear/caps.stl
67.2 x 9.40 x 7.65
