allenleejy/digicam/cad/export/v3/retro/back_plate.stl

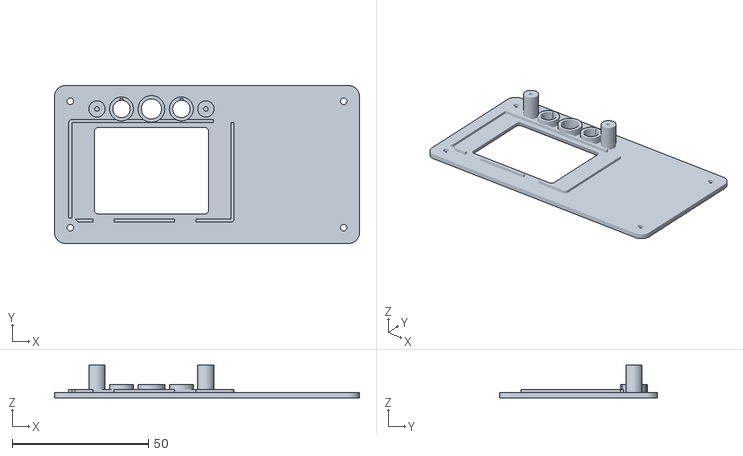
[picture p75: CAD file, 2026-10-23]
cad/export/v3/retro/back_plate.stl
112.0 x 58.0 x 12.1
