allenleejy/digicam/guide/models/w_buttons.stl

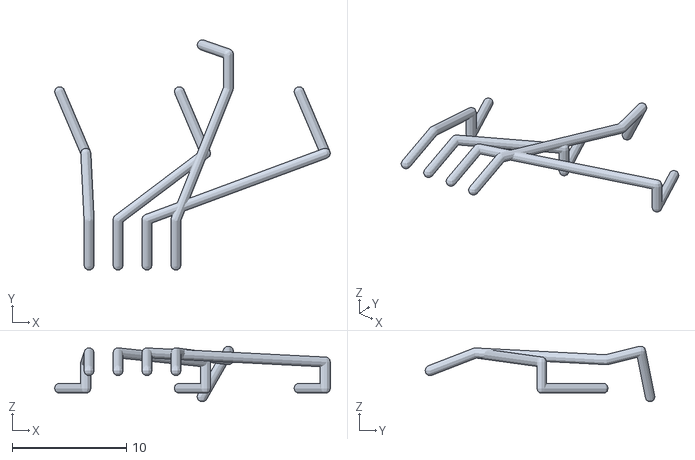
[picture p76: CAD file, 2026-10-21]
guide/models/w_buttons.stl
24.2 x 20.2 x 4.86
