allenleejy/digicam/cad/export/v3/clear/panel.stl

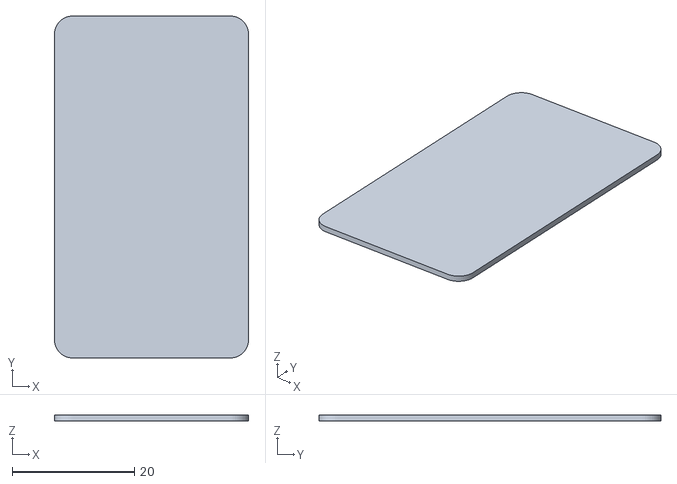
[picture p77: CAD file, 2026-10-23]
cad/export/v3/clear/panel.stl
31.8 x 56.0 x 1.00
