allenleejy/digicam/cad/export/v3/retro/caps.stl

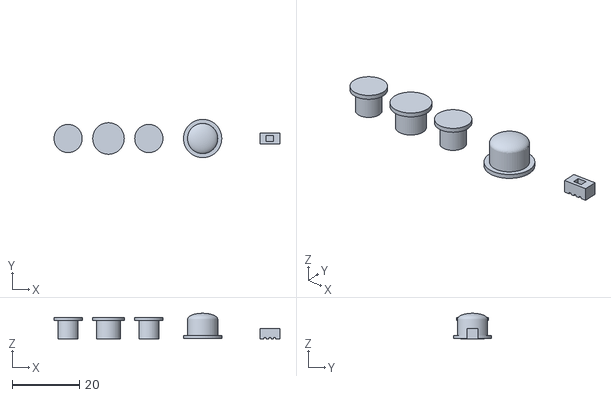
[picture p78: CAD file, 2026-10-23]
cad/export/v3/retro/caps.stl
67.2 x 11.4 x 7.60
