allenleejy/digicam/guide/models/camera_glass.stl

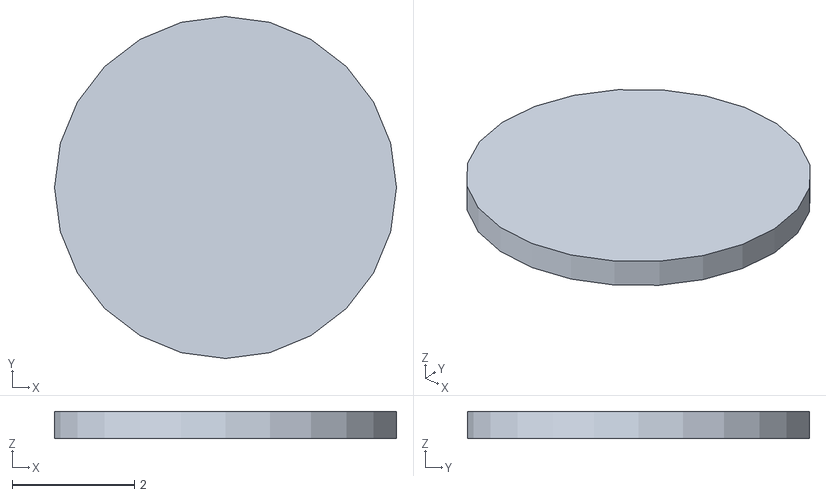
[picture p79: CAD file, 2026-10-21]
guide/models/camera_glass.stl
5.60 x 5.60 x 0.45
