allenleejy/digicam/cad/export/v3/retro/top_bits.stl

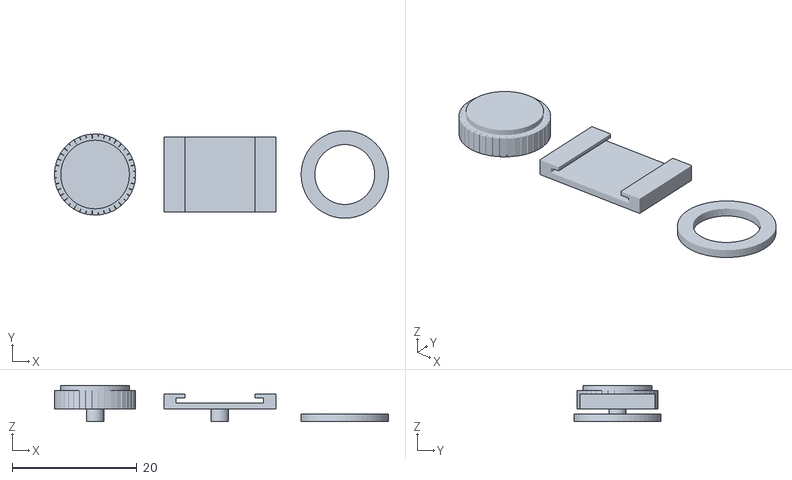
[picture p80: CAD file, 2026-10-23]
cad/export/v3/retro/top_bits.stl
53.5 x 14.0 x 5.80
