allenleejy/digicam/guide/models/w_screen_0.stl

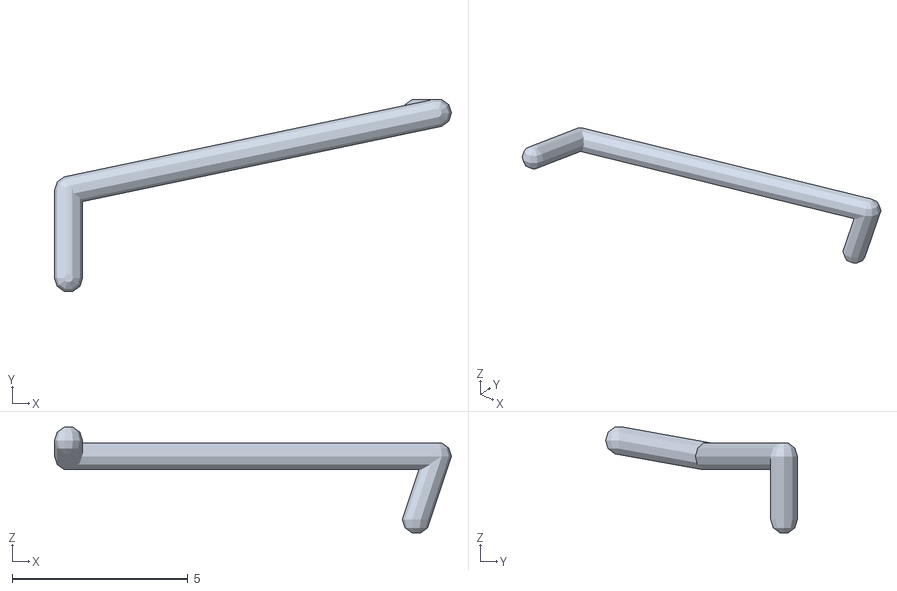
[picture p81: CAD file, 2026-10-21]
guide/models/w_screen_0.stl
11.3 x 5.46 x 3.01
