allenleejy/digicam/cad/export/v3/clear/lens_ring.stl

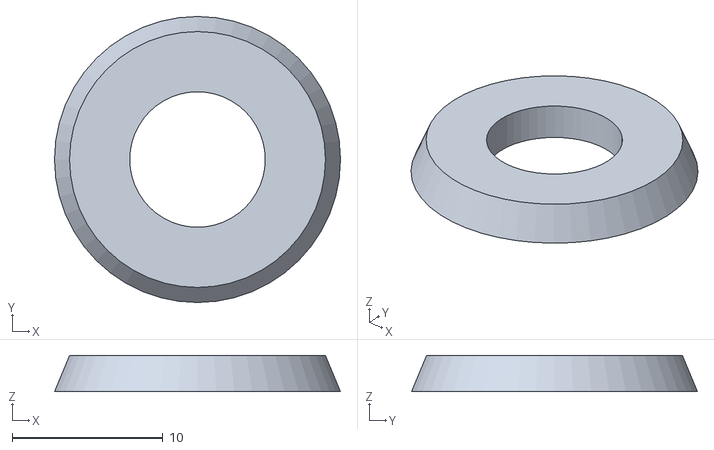
[picture p82: CAD file, 2026-10-23]
cad/export/v3/clear/lens_ring.stl
19.0 x 19.0 x 2.40
