allenleejy/digicam/cad/export/v3/retro/back_leatherette.stl

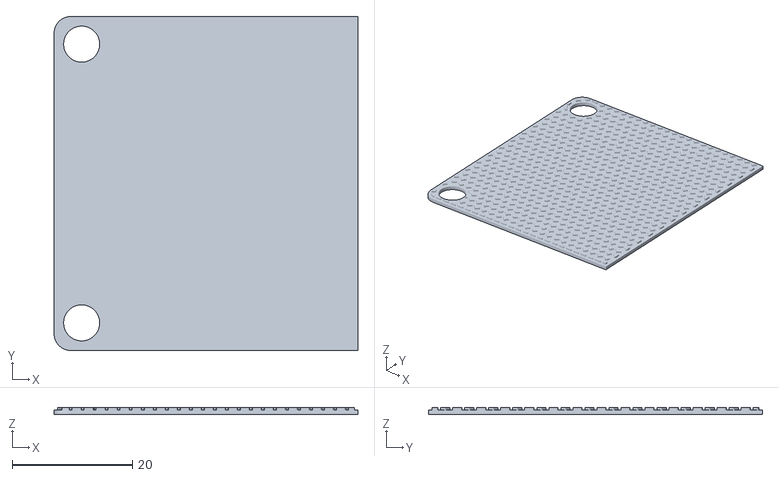
[picture p83: CAD file, 2026-10-23]
cad/export/v3/retro/back_leatherette.stl
50.6 x 55.6 x 1.19
