allenleejy/digicam/guide/models/board_pcb.stl

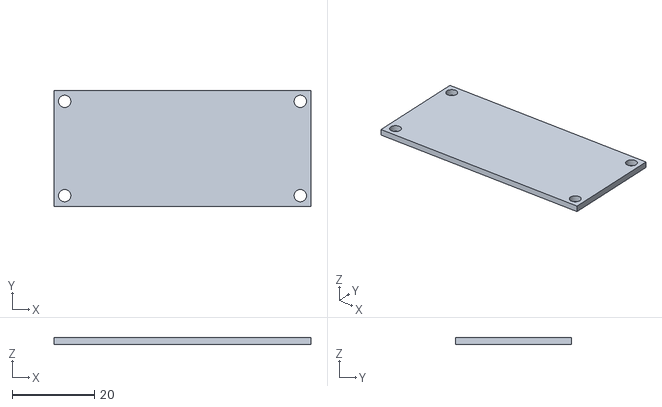
[picture p84: CAD file, 2026-10-21]
guide/models/board_pcb.stl
62.4 x 28.1 x 1.60
