allenleejy/digicam/guide/models/w_button_gnd.stl

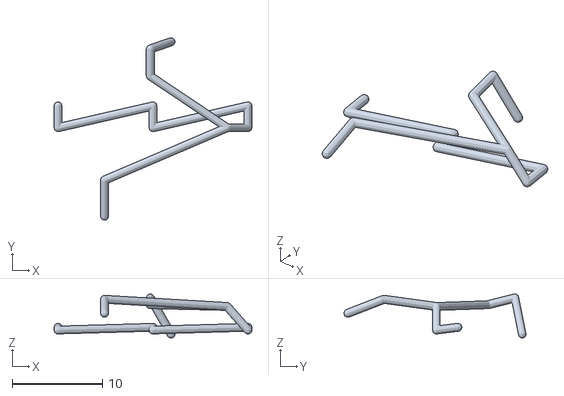
[picture p85: CAD file, 2026-10-21]
guide/models/w_button_gnd.stl
21.9 x 20.2 x 4.86
