allenleejy/digicam/guide/models/w_screen_5.stl

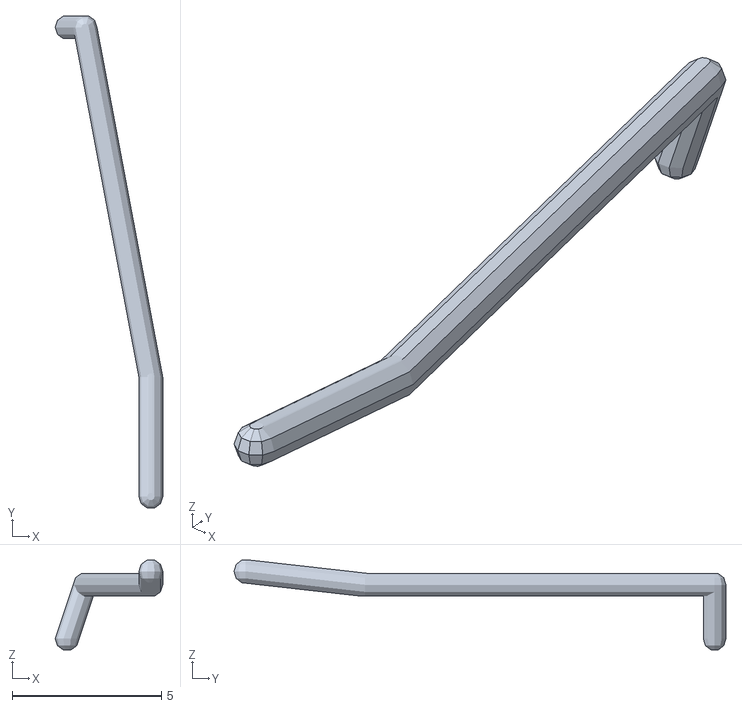
[picture p86: CAD file, 2026-10-21]
guide/models/w_screen_5.stl
3.60 x 16.5 x 3.01
