allenleejy/digicam/guide/models/shutter_sw.stl

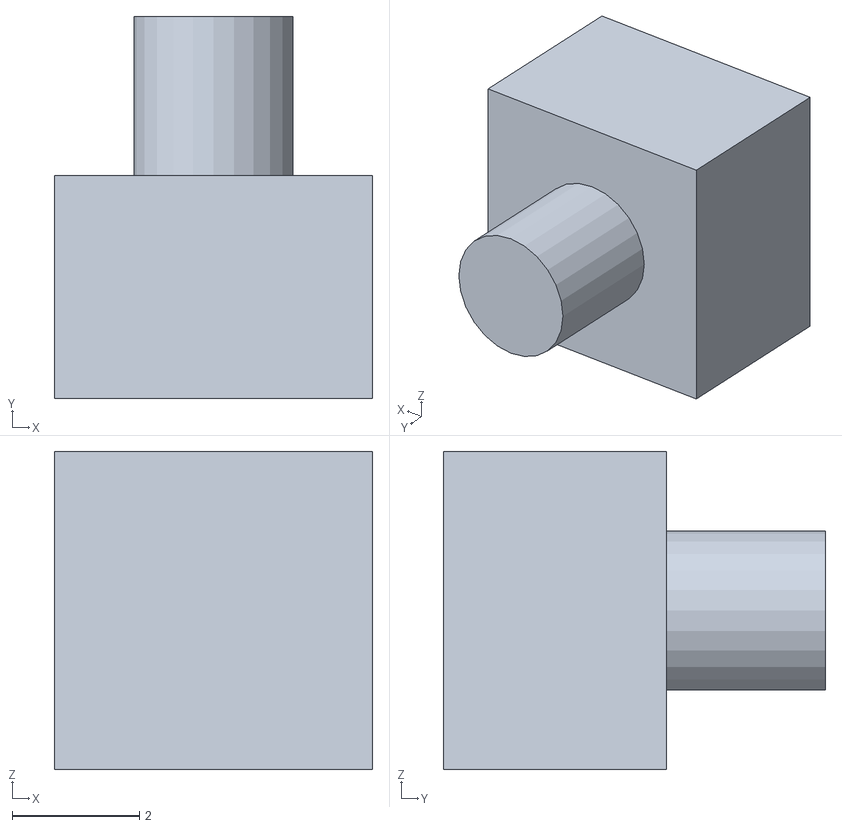
[picture p87: CAD file, 2026-10-21]
guide/models/shutter_sw.stl
5.00 x 6.00 x 5.00
