allenleejy/digicam/guide/models/sled.stl

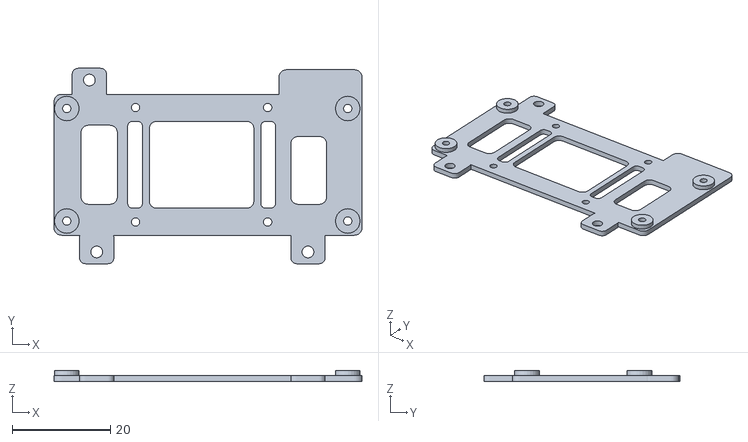
[picture p88: CAD file, 2026-10-21]
guide/models/sled.stl
62.7 x 39.8 x 2.20
