allenleejy/digicam/guide/models/w_bat_black.stl

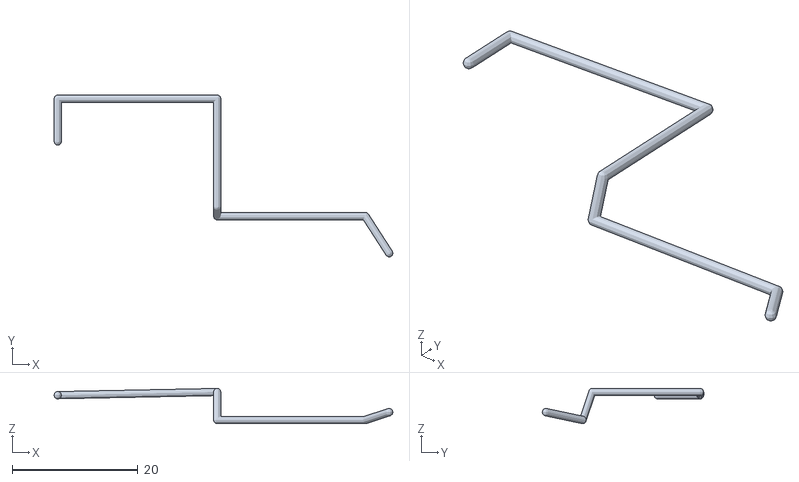
[picture p89: CAD file, 2026-10-21]
guide/models/w_bat_black.stl
54.0 x 25.7 x 5.59
