allenleejy/digicam/guide/models/charger_pcb.stl

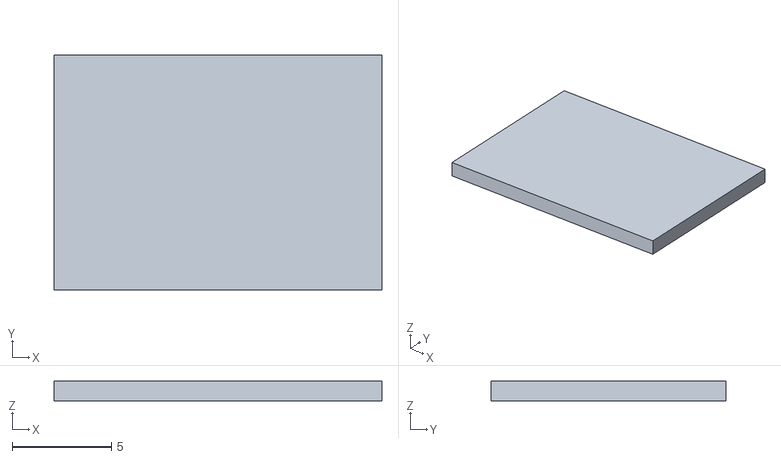
[picture p90: CAD file, 2026-10-21]
guide/models/charger_pcb.stl
16.5 x 11.8 x 1.00
