allenleejy/digicam/guide/models/shutter_cap.stl

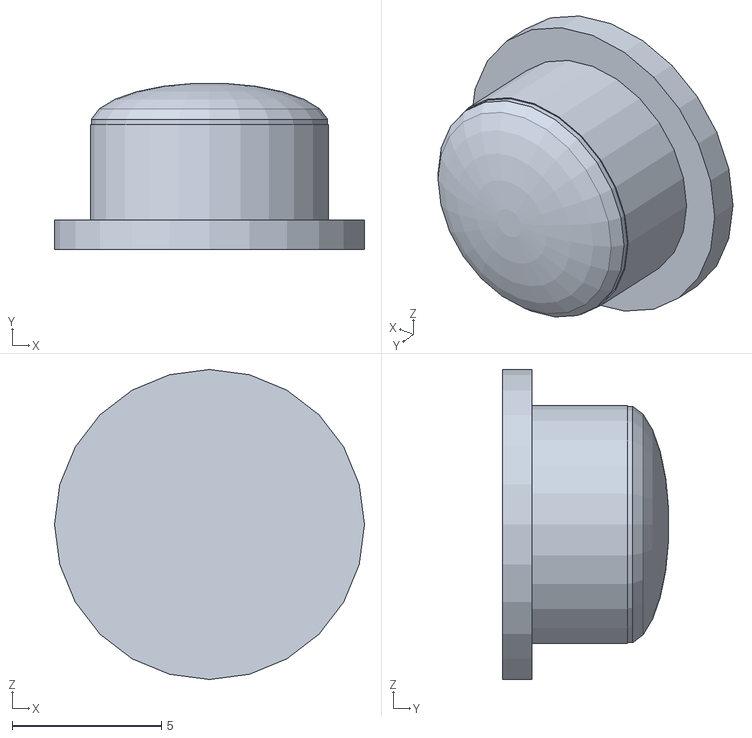
[picture p91: CAD file, 2026-10-21]
guide/models/shutter_cap.stl
10.4 x 5.58 x 10.4
