allenleejy/digicam/guide/models/button_feet.stl

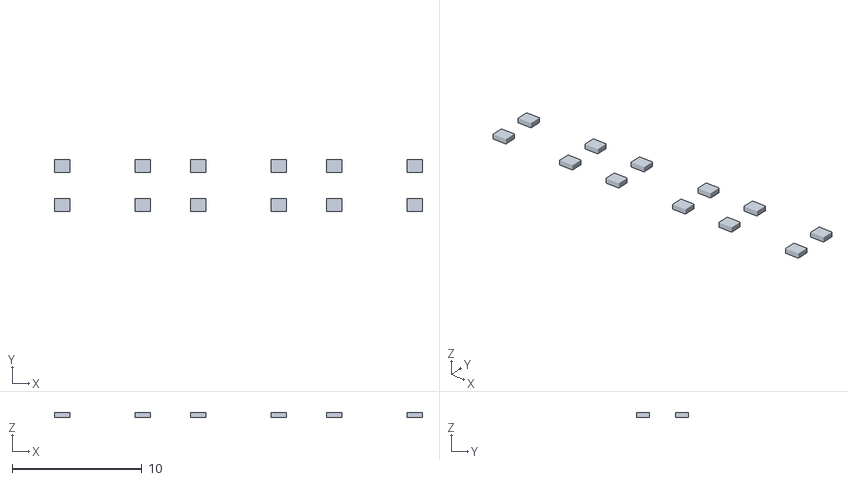
[picture p92: CAD file, 2026-10-21]
guide/models/button_feet.stl
28.4 x 4.00 x 0.4
