allenleejy/digicam/guide/models/board_parts.stl

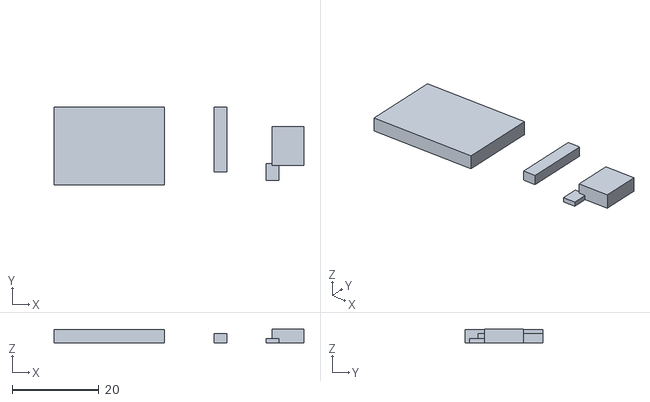
[picture p93: CAD file, 2026-10-21]
guide/models/board_parts.stl
57.8 x 18.0 x 3.20
