allenleejy/digicam/guide/models/front_plate.stl

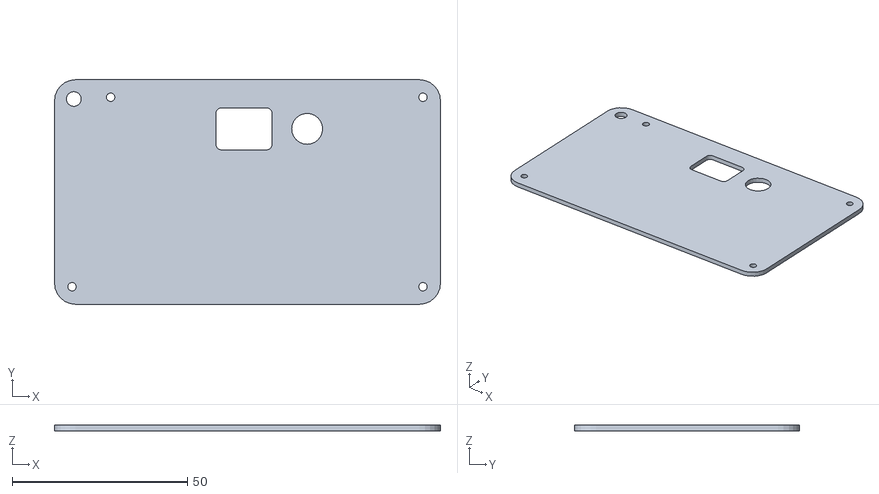
[picture p94: CAD file, 2026-10-21]
guide/models/front_plate.stl
110.0 x 64.0 x 1.60
