allenleejy/digicam/guide/models/inserts_back.stl

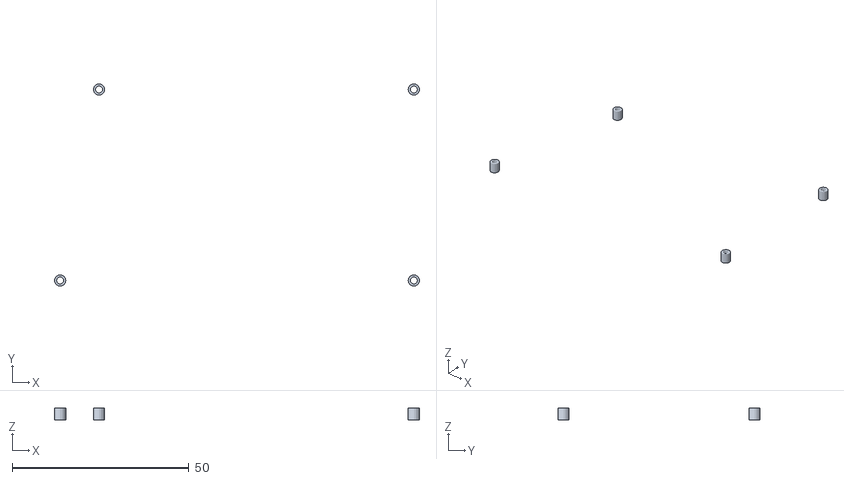
[picture p95: CAD file, 2026-10-21]
guide/models/inserts_back.stl
103.2 x 57.2 x 3.50
