allenleejy/digicam/guide/models/w_screen_7.stl

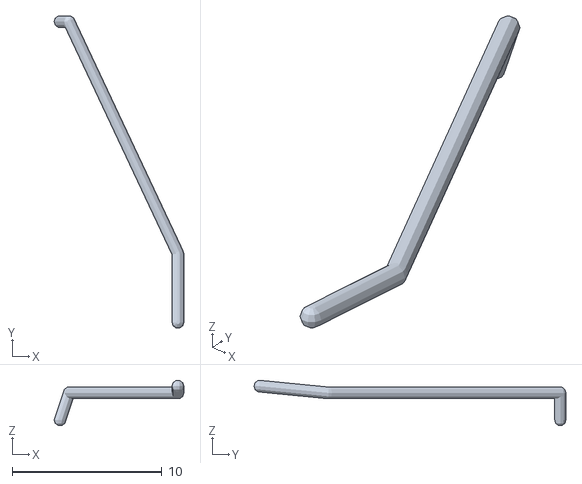
[picture p96: CAD file, 2026-10-21]
guide/models/w_screen_7.stl
8.68 x 20.9 x 3.01
