allenleejy/digicam/guide/models/w_sense.stl

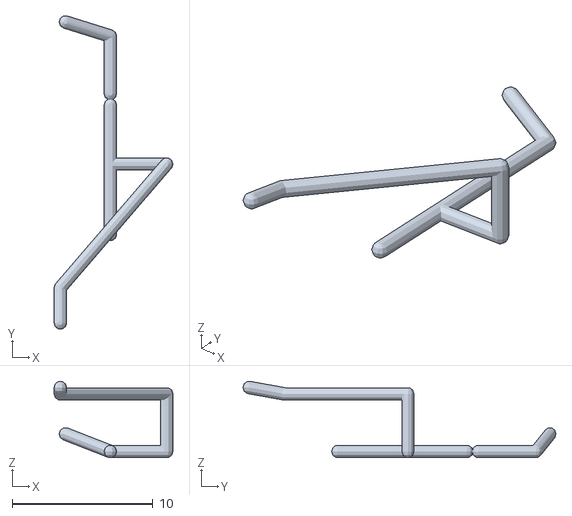
[picture p97: CAD file, 2026-10-21]
guide/models/w_sense.stl
8.46 x 22.3 x 5.41
