allenleejy/digicam/guide/models/inserts_sled.stl

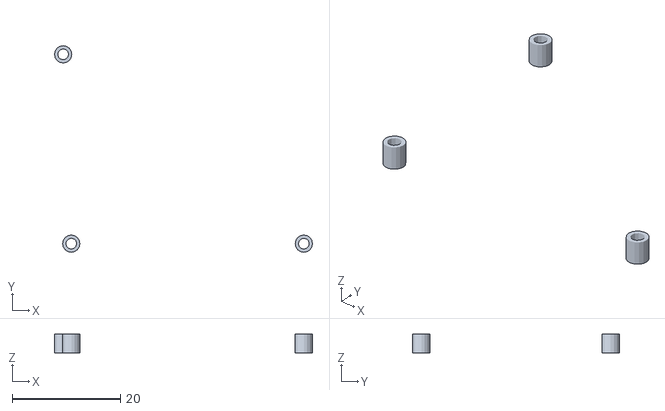
[picture p98: CAD file, 2026-10-21]
guide/models/inserts_sled.stl
47.7 x 38.2 x 3.50
