allenleejy/digicam/guide/models/screen_pcb.stl

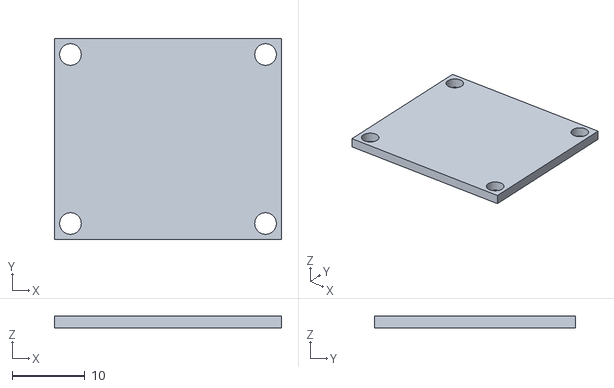
[picture p99: CAD file, 2026-10-21]
guide/models/screen_pcb.stl
31.3 x 27.7 x 1.60
