allenleejy/digicam/guide/models/tape.stl

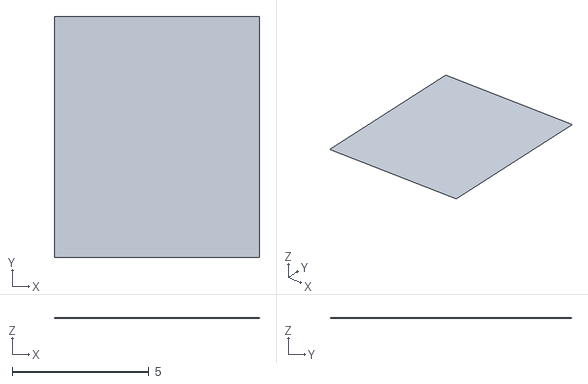
[picture p100: CAD file, 2026-10-21]
guide/models/tape.stl
7.50 x 8.80 x 0.02
