allenleejy/digicam/guide/models/camera.stl

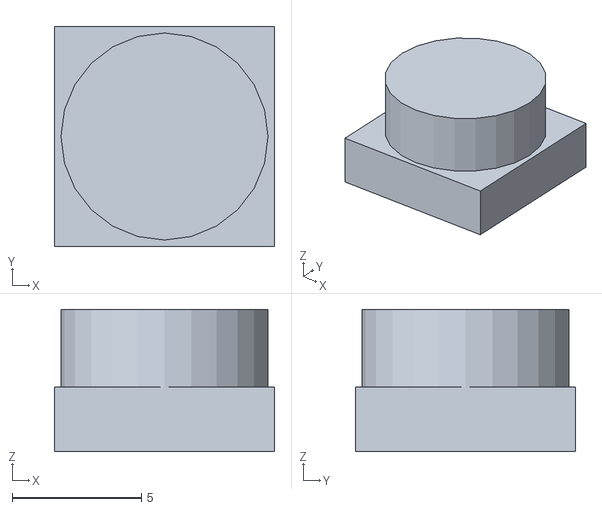
[picture p101: CAD file, 2026-10-21]
guide/models/camera.stl
8.50 x 8.50 x 5.50
