allenleejy/digicam/guide/models/w_power.stl

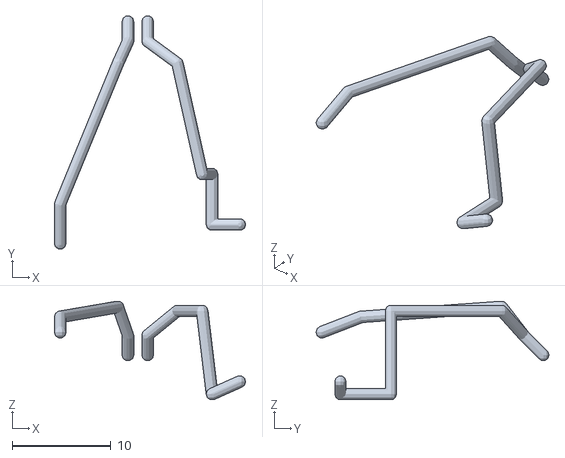
[picture p102: CAD file, 2026-10-21]
guide/models/w_power.stl
19.3 x 23.5 x 9.94
