allenleejy/digicam/guide/models/resistors.stl

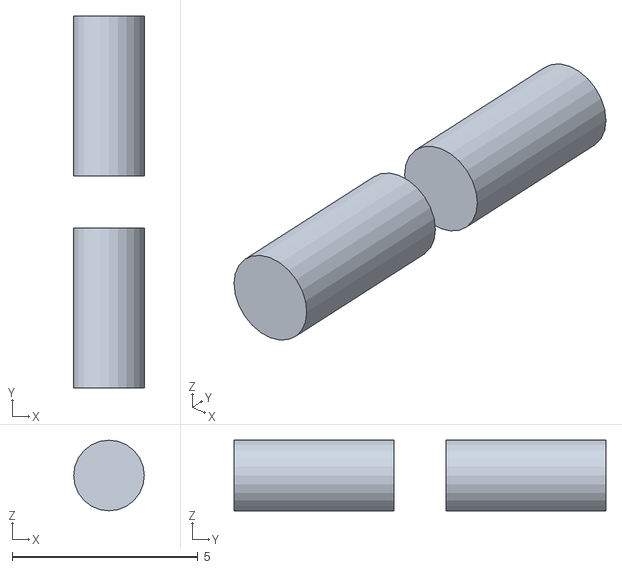
[picture p103: CAD file, 2026-10-21]
guide/models/resistors.stl
1.90 x 10.0 x 1.90
