allenleejy/digicam/guide/models/w_screen_1.stl

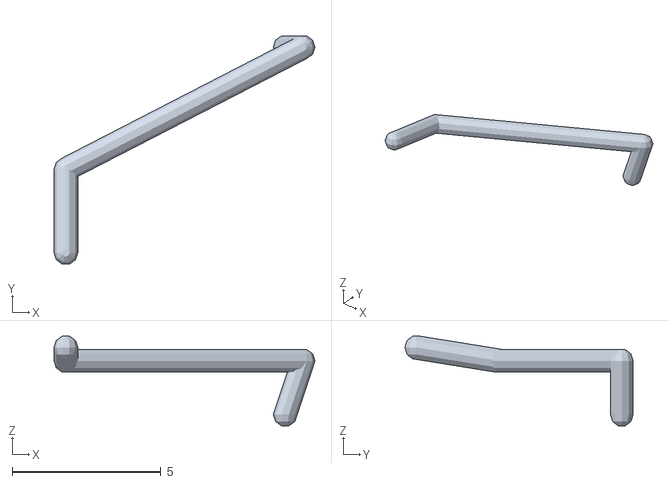
[picture p104: CAD file, 2026-10-21]
guide/models/w_screen_1.stl
8.76 x 7.66 x 3.01
