allenleejy/digicam/guide/models/caps.stl

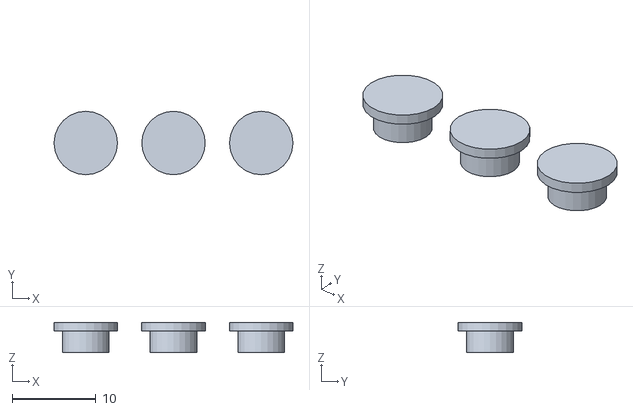
[picture p105: CAD file, 2026-10-21]
guide/models/caps.stl
28.6 x 7.60 x 3.59
