allenleejy/digicam/guide/models/foam.stl

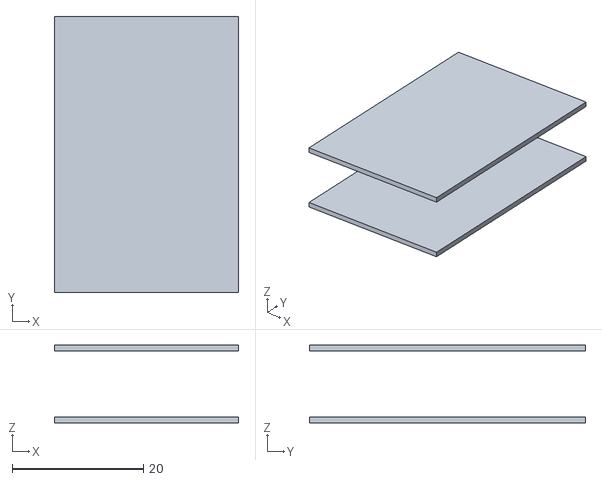
[picture p106: CAD file, 2026-10-21]
guide/models/foam.stl
28.0 x 42.0 x 11.8
