allenleejy/digicam/guide/models/ribbon.stl

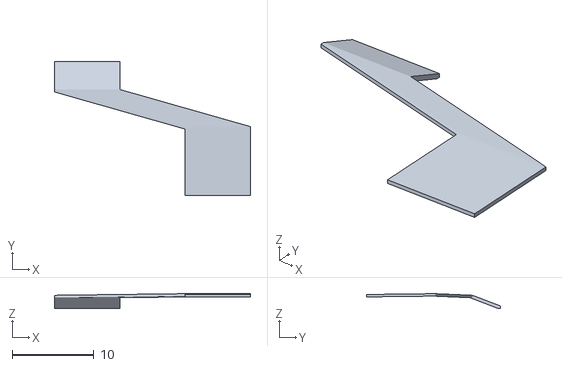
[picture p107: CAD file, 2026-10-21]
guide/models/ribbon.stl
24.0 x 16.4 x 1.80
