allenleejy/digicam/guide/models/buttons.stl

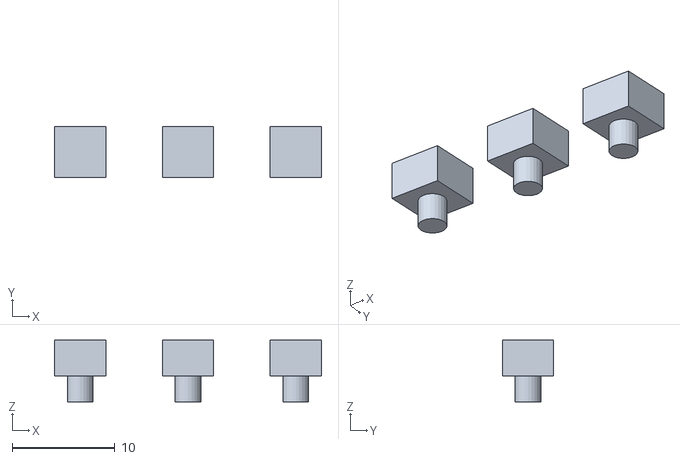
[picture p108: CAD file, 2026-10-21]
guide/models/buttons.stl
26.0 x 5.00 x 6.00
