allenleejy/digicam/guide/models/slide_sw.stl

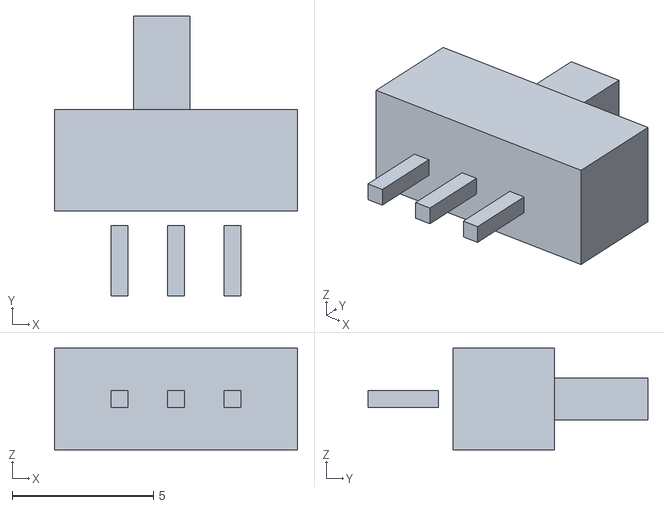
[picture p109: CAD file, 2026-10-21]
guide/models/slide_sw.stl
8.60 x 9.90 x 3.60
