allenleejy/digicam/guide/models/screen_glass.stl

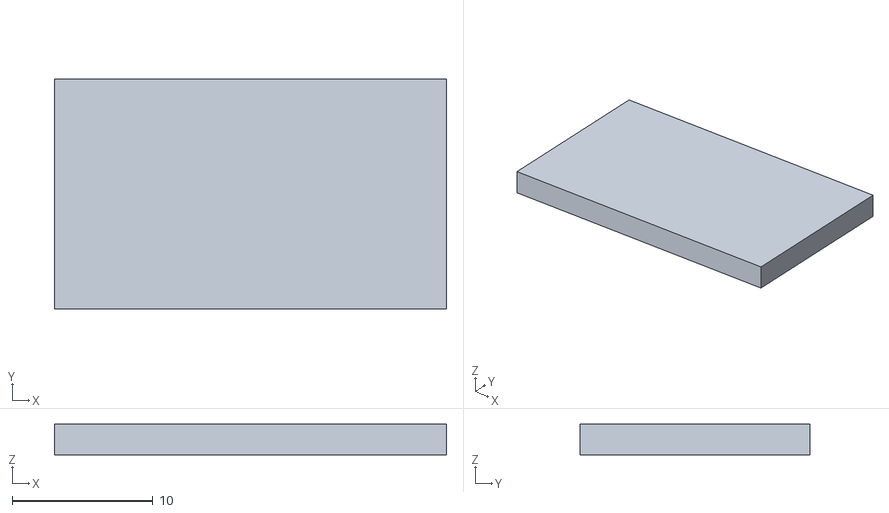
[picture p110: CAD file, 2026-10-21]
guide/models/screen_glass.stl
27.9 x 16.4 x 2.20
