allenleejy/digicam/guide/models/charger_parts.stl

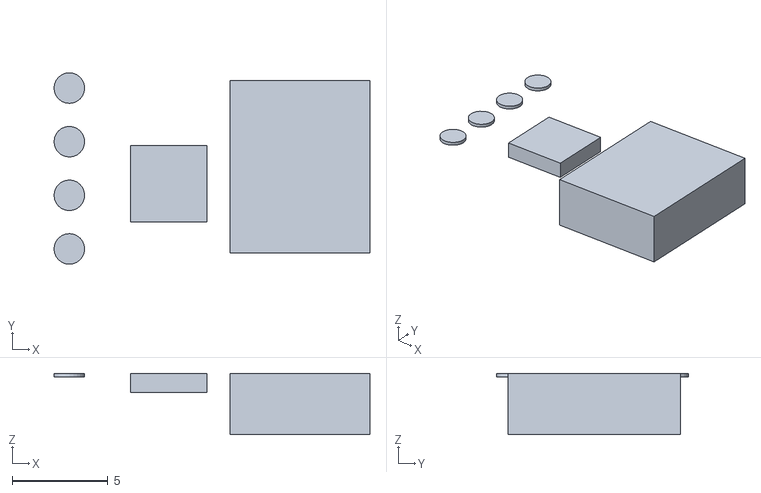
[picture p111: CAD file, 2026-10-21]
guide/models/charger_parts.stl
16.5 x 10.0 x 3.20
