allenleejy/digicam/guide/models/screen_active.stl

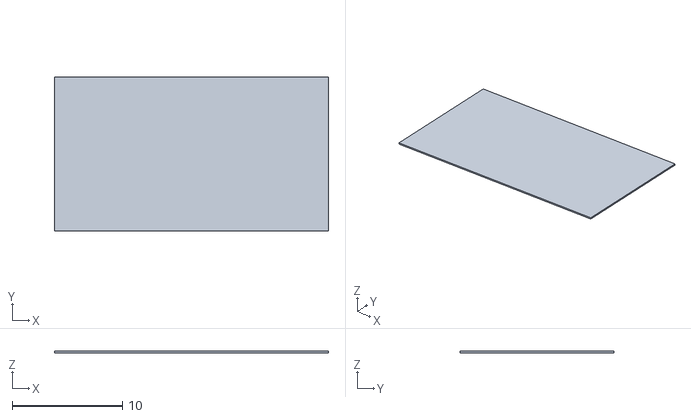
[picture p112: CAD file, 2026-10-21]
guide/models/screen_active.stl
24.9 x 14.0 x 0.15
