allenleejy/digicam/guide/models/w_screen_3.stl

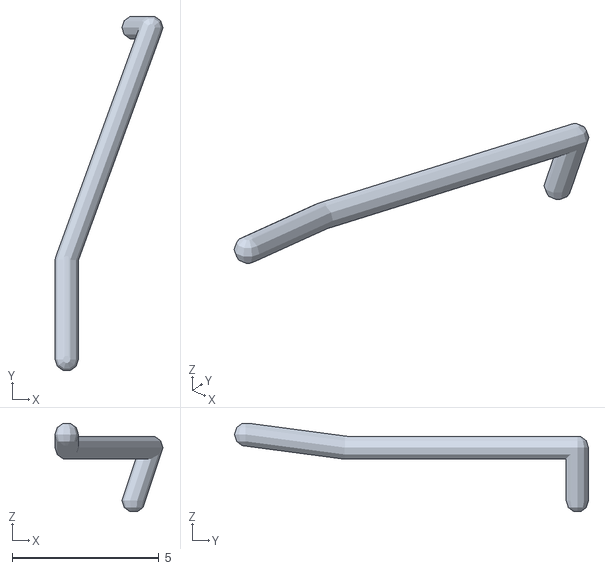
[picture p113: CAD file, 2026-10-21]
guide/models/w_screen_3.stl
3.68 x 12.1 x 3.01
