allenleejy/digicam/guide/models/battery.stl

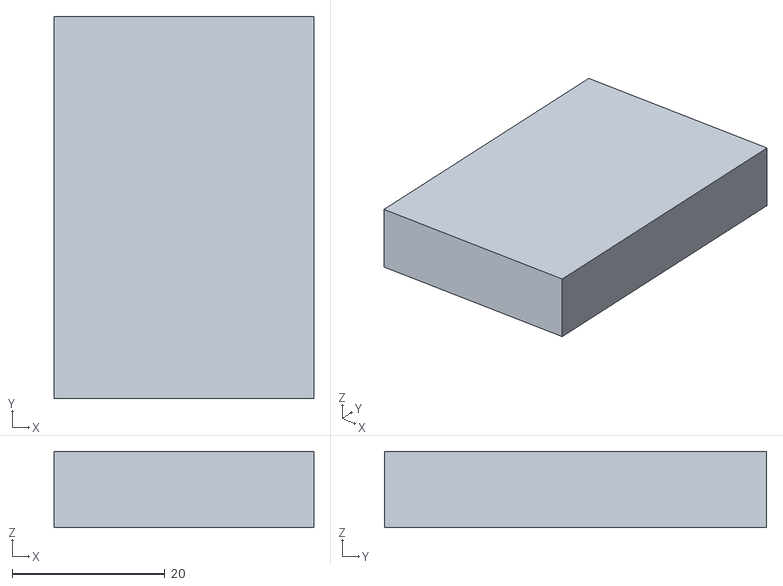
[picture p114: CAD file, 2026-10-21]
guide/models/battery.stl
34.0 x 50.0 x 10.0
