allenleejy/digicam/guide/models/w_screen_6.stl

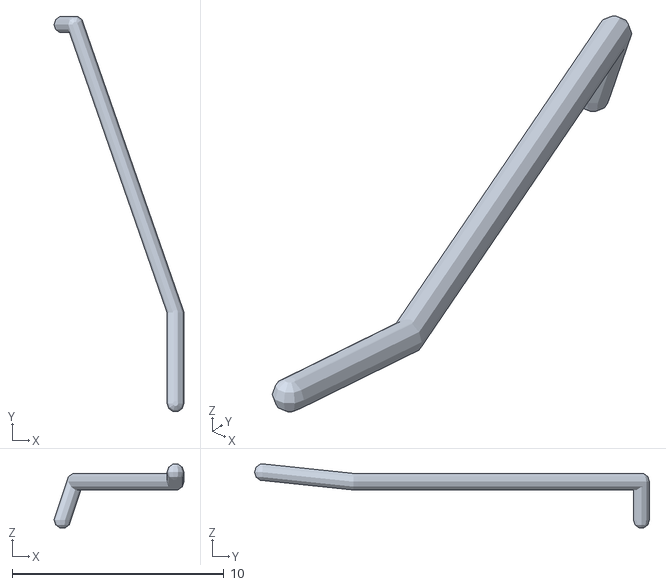
[picture p115: CAD file, 2026-10-21]
guide/models/w_screen_6.stl
6.14 x 18.7 x 3.01
