allenleejy/digicam/guide/models/w_bat_red.stl

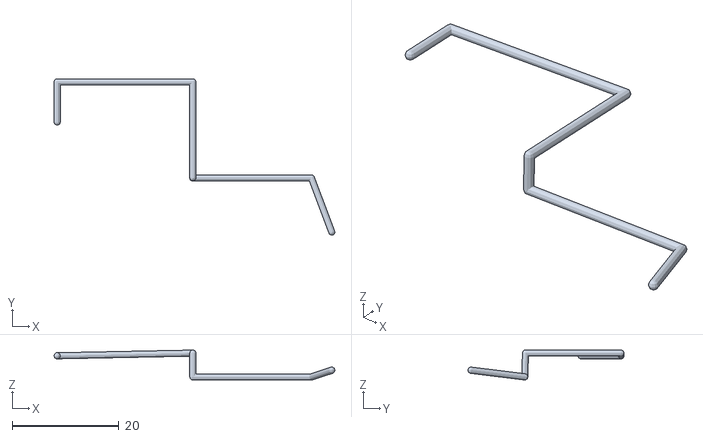
[picture p116: CAD file, 2026-10-21]
guide/models/w_bat_red.stl
52.6 x 29.2 x 5.59
