allenleejy/digicam/(list of files, cad)

Other CAD files:
cad/export/v3/clear/front_plate_lasercut.dxf
cad/export/v3/clear/back_plate_lasercut.dxf
cad/export/step_parts/button_cap_prev.step
cad/export/step_parts/viewfinder_trim_front.step
cad/export/step_parts/viewfinder_trim_back.step
cad/export/step_parts/button_cap_next.step
guide/models/inserts_front.stl
guide/models/back_plate.stl
guide/models/vf_back.stl
guide/models/lens_ring.stl
cad/camera1_v2.scad
cad/export/back_plate.stl
cad/export/back_plate_lasercut.dxf
cad/export/caps.stl
cad/export/frame.stl
cad/export/front_plate.stl
cad/export/front_plate_lasercut.dxf
cad/export/lens_ring.stl
cad/export/v2/back_plate.stl
cad/export/v2/back_plate_lasercut.dxf
cad/export/v2/caps.stl
cad/export/v2/frame.stl
cad/export/v2/front_plate.stl
cad/export/v2/front_plate_lasercut.dxf
cad/export/v2/lens_ring.stl
cad/export/v2/sled.stl
cad/export/v2/vf_frames.stl
cad/fusion/camera1_parametric.f3d
cad/guide_parts.scad
guide/models/screws_back.stl
guide/models/screws_board.stl
guide/models/screws_front.stl
guide/models/screws_screen.stl
guide/models/screws_sled.stl
