allenleejy/digicam/cad/renders/frame_print.png

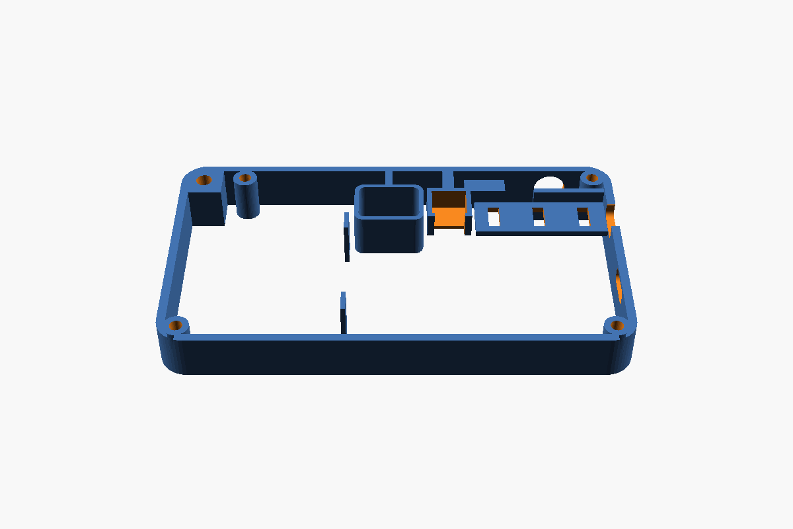
cad/renders/frame_print.png
