allenleejy/digicam/guide/v3/clear_step01.png

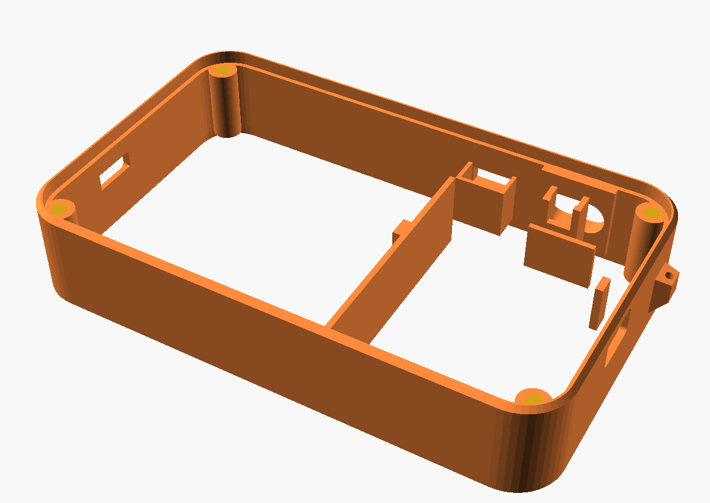
guide/v3/clear_step01.png
