allenleejy/digicam/guide/v3/clear_step02.png

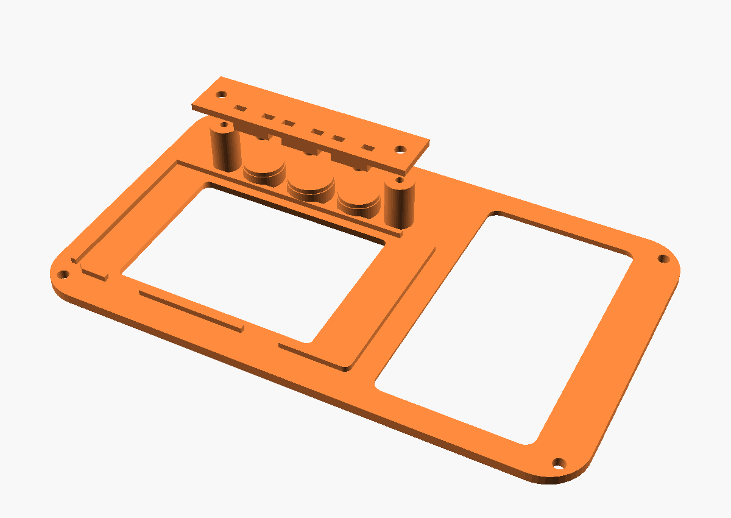
guide/v3/clear_step02.png
