allenleejy/digicam/guide/v3/clear_step03.png

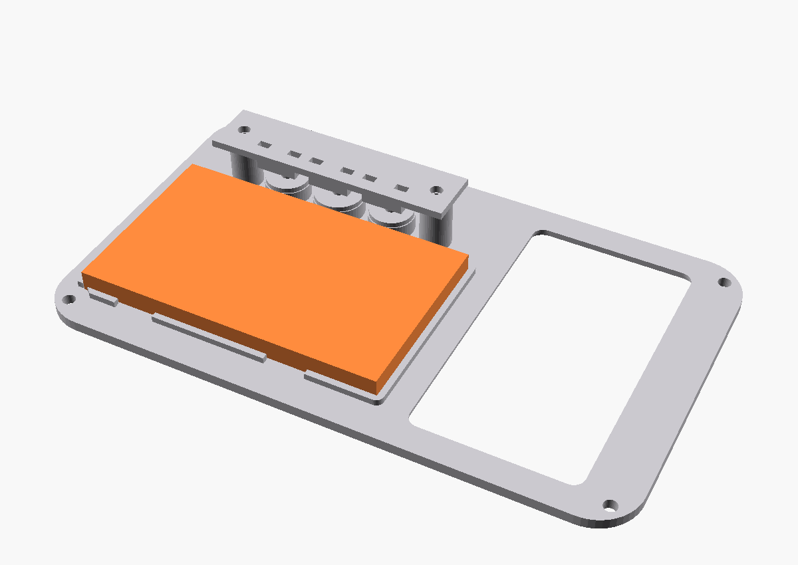
guide/v3/clear_step03.png
