allenleejy/digicam/guide/v3/clear_step06.png

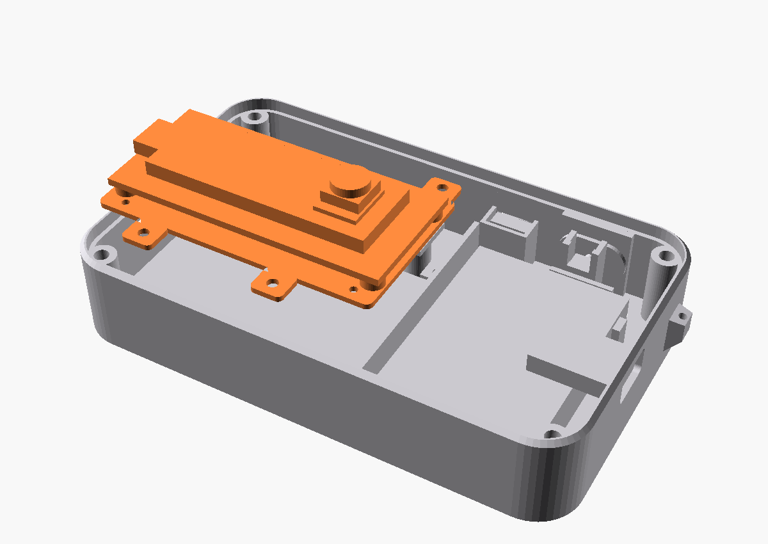
guide/v3/clear_step06.png
