allenleejy/digicam/guide/v3/clear_step07.png

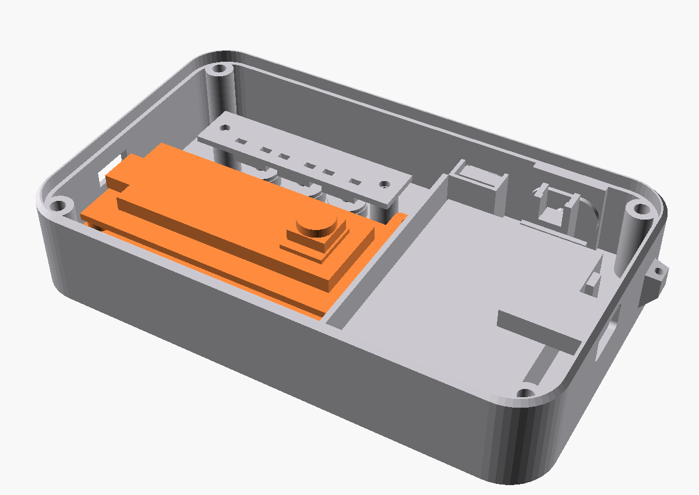
guide/v3/clear_step07.png
