allenleejy/digicam/guide/v3/clear_step09.png

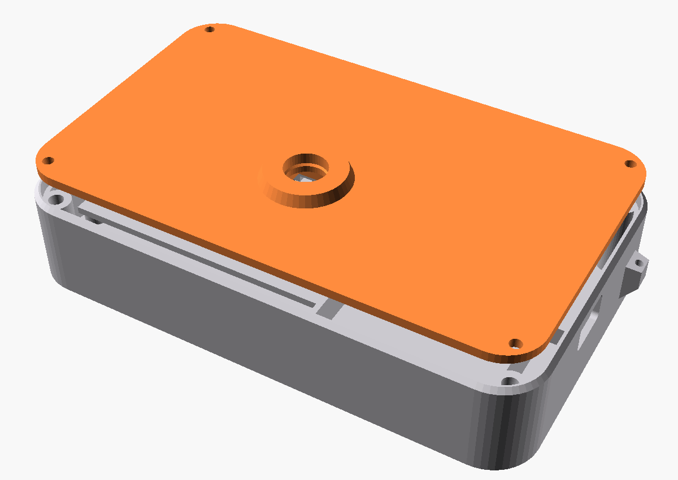
guide/v3/clear_step09.png
