allenleejy/digicam/guide/v3/clear_step10.png

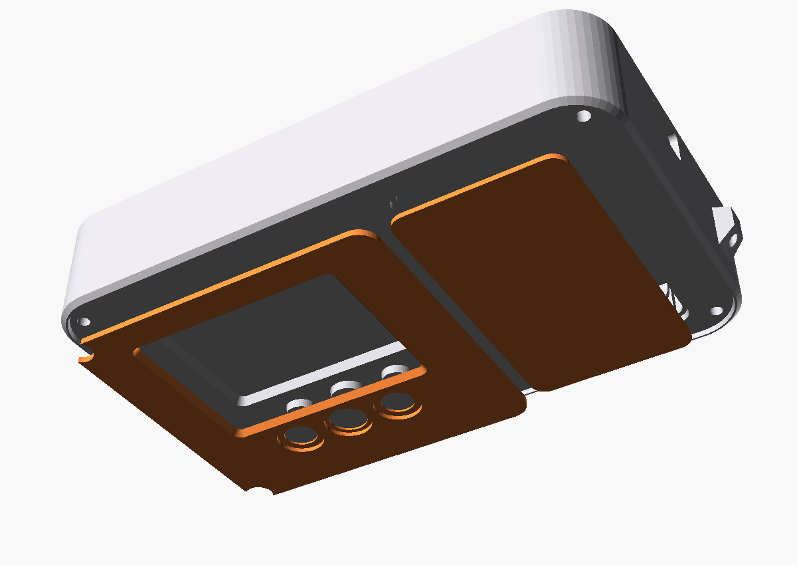
guide/v3/clear_step10.png
