allenleejy/digicam/guide/v3/retro_step01.png

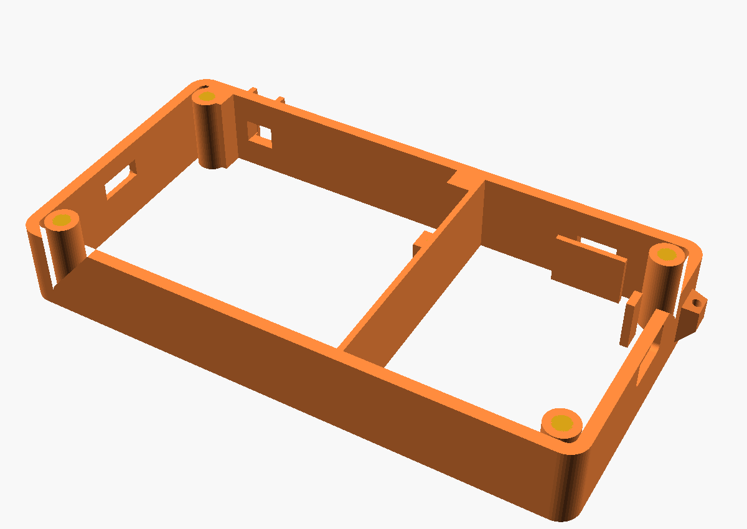
guide/v3/retro_step01.png
