allenleejy/digicam/guide/v3/retro_step02.png

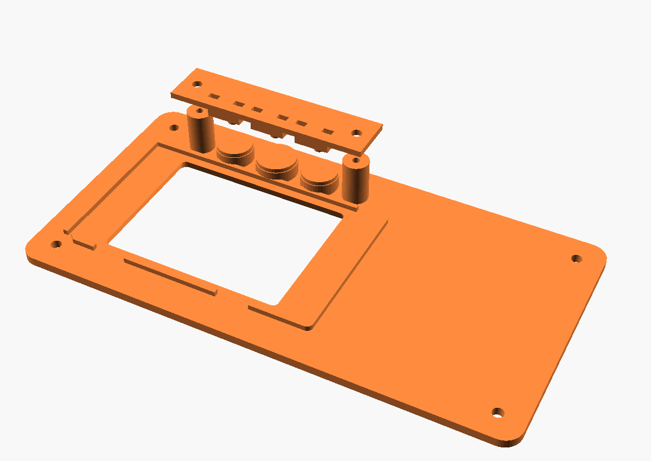
guide/v3/retro_step02.png
