allenleejy/digicam/guide/v3/retro_step05.png

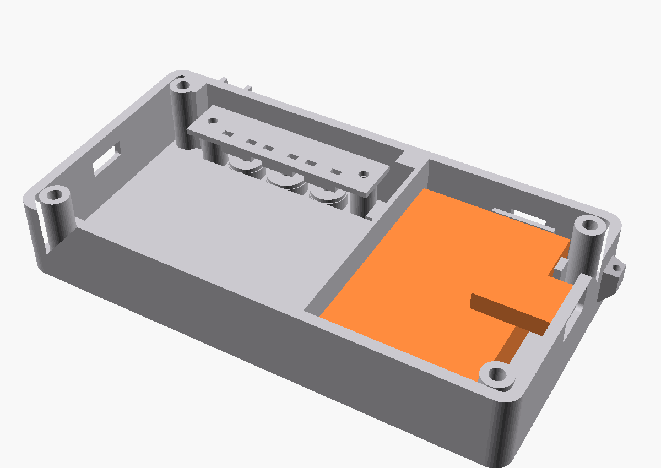
guide/v3/retro_step05.png
