allenleejy/digicam/guide/v3/retro_step06.png

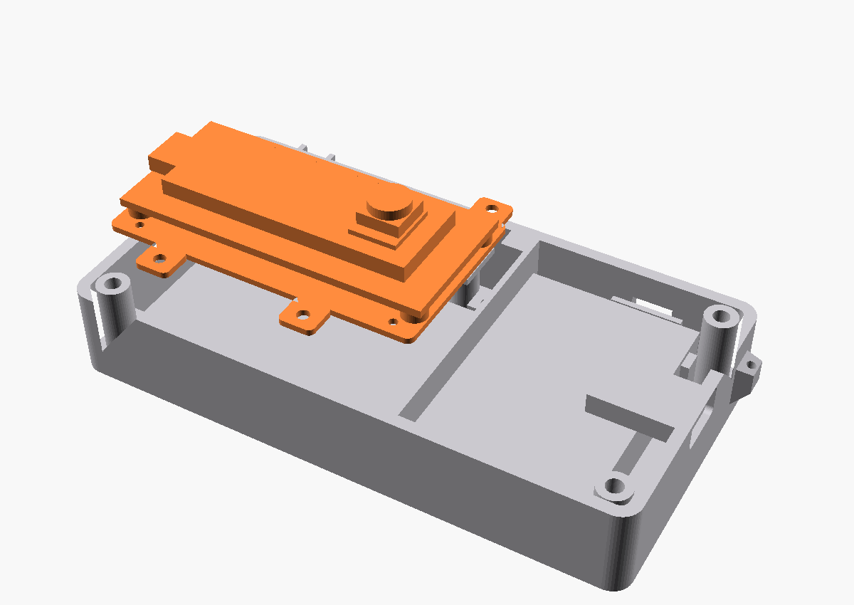
guide/v3/retro_step06.png
