allenleejy/digicam/guide/v3/retro_step07.png

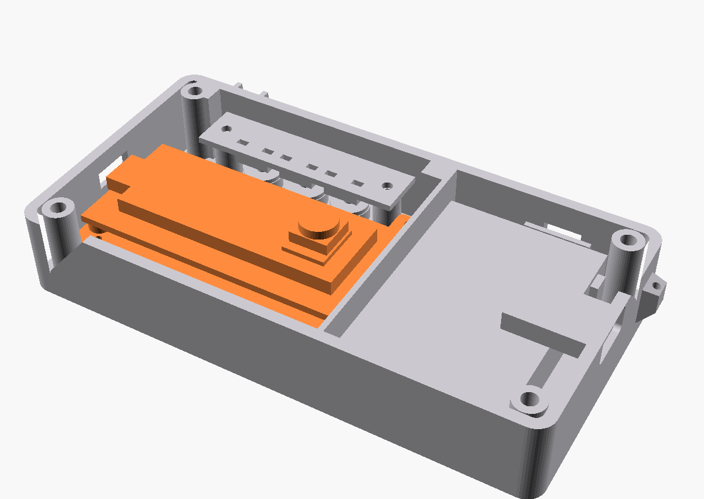
guide/v3/retro_step07.png
