allenleejy/digicam/guide/v3/retro_step08.png

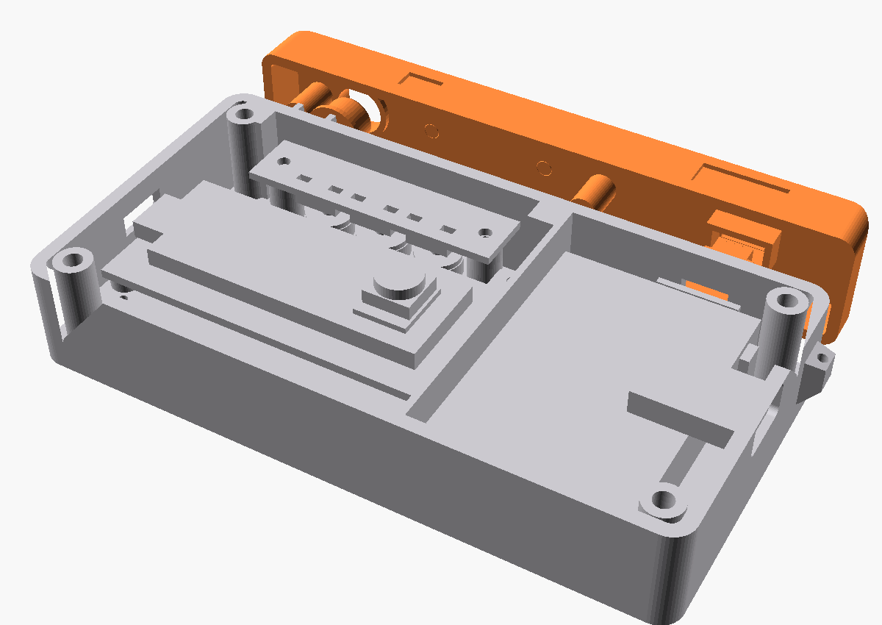
guide/v3/retro_step08.png
