allenleejy/digicam/guide/v3/retro_step09.png

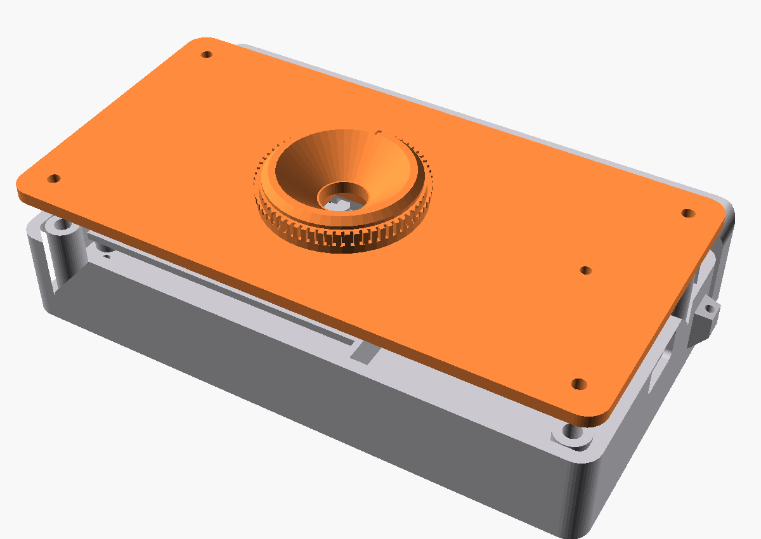
guide/v3/retro_step09.png
