allenleejy/digicam/guide/v3/retro_step10.png

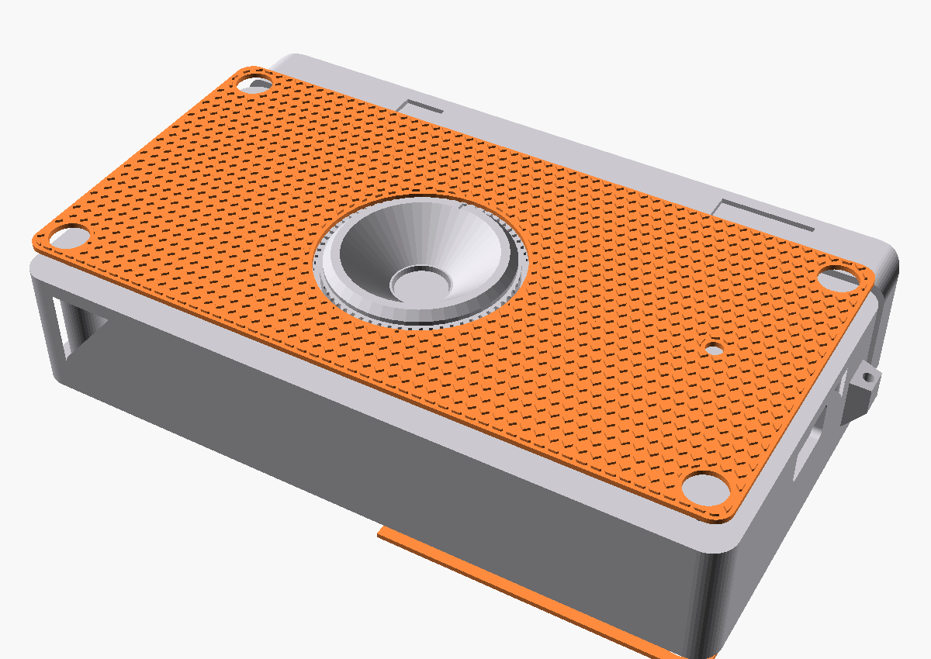
guide/v3/retro_step10.png
