allenleejy/digicam/firmware/main/personal.h

#pragma once

/*
 * personal.h: per-camera settings. Set these before flashing each friend's camera.
 */

/* Shown on the start-up screen as "hi, <name>". Leave empty for "ready when you are". */
#define OWNER_NAME ""
