allenleejy/digicam/(commit log)

2026-10-21 Gift cameras: firmware 0.3.0 with Phone mode, v2 case CAD, assembly guide, docs
    [back_plate.step, back_plate.stl, back_plate_lasercut.dxf, battery.stl, board_pads.stl, board_parts.stl, board_pcb.stl, button_cap_next.step]
2026-10-23 changes to make compatible with digigallery and speed test
    [back_leatherette.stl, back_plate.stl, back_plate_lasercut.dxf, bezel.stl, camera1_v3.scad, caps.stl, carrier.stl, frame.stl]
2026-10-23 Firmware 0.4.0: frame mailbox, new phone page, video fix, Wi-Fi tuning and channel pick
    - /api/frame mailbox for the DigiGallery frame (items 1, 2, 3, 5 of Allen's request)
    - phone page rebuilt in the new design (web/phone.src.html + build.py): full-quality saves
    only, thumbnail-first viewer with neighbour prefetch, thumbnails 3 at a time, optional
    Shortcut, frame features, Home Screen icon
    - video after Phone mode: one internal buffer set aside at start-up, shared with Phone mode
    - Wi-Fi: 8 TCP segments in flight, 15 s send timeout, quietest of channels 1/6/11
    - heap logging in Phone mode; frame.json readable over USB
    - host: perf_test.py (capture and data loss over USB), wifi_test.py (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
    [avi.c, main.c, perf_test.py, phone.c, phone.h, server.py, storage.c]
2026-10-23 feat: firmware 0.4.1, /small for the DigiGallery frame and the file-number fix
    - GET /small/NAME?w=W&h=H (small.c): decode at the biggest reduction that covers, crop the
    middle, box filter, encode with fmt2jpg at quality 80 (60 if over 24 KB); kept in DCIM/.small/
    - next file number also kept in NVS (digicam/next_num), so a format and a restart carry on
    - jpge's 8 KB of tables, lwIP's and the Wi-Fi libraries' fixed variables moved to PSRAM
    (SPIRAM_ALLOW_BSS_SEG_EXTERNAL_MEMORY, main/linker.lf): Phone mode 49-50 KB internal free
    - host/server.py finds the CH340 on Windows
    [main.c, phone.c, server.py, small.c, small.h, storage.c, storage.h]
2026-10-23 fix: firmware 0.4.2, full files and the page sent from their own task
    The web server runs one handler at a time, so a long download held up every
    other client: with an iPhone on the phone page a 4.9 MB video took 42 s and the
    DigiGallery frame's GET /api/frame timed out behind it twice (it gives up at 8 s).
    - /file/ and / go to big_task through httpd async requests, one at a time in the
    order asked, with an 8 KB internal read buffer of their own; thumbnails, /small,
    /api/list and the mailbox stay on the server's task
    - a full queue, or no memory for the task, sends on the server's task as before
    - a failed send closes its connection; leaving Phone mode cuts a send short
    - requests takin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
    [main.c, phone.c]
2026-10-23 feat: firmware 0.4.3, the page at http://gallery.local
    - mDNS (espressif/mdns 1.14.1) answers gallery.local on the camera's own network
    (PHONE_HOST in phone.h); started before the network comes up, freed with it
    - the "see the photos" QR code and the address on the Phone mode screen are now
    http://gallery.local/; 192.168.4.1 keeps working, for the DigiGallery frame and
    for phones that don't look up .local names (Chrome on Android)
    - mDNS's memory and task stack are in PSRAM, and big_task's read buffer is 4 KB:
    with mDNS in internal RAM, Phone mode fell to 17 KB free while the frame's
    /small was made during the phone's downloads. Now 38 KB free at start (0.4.2: 37)
    Tested on an iPh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
